thomaslr/plant-esp32/pcb/hole-thru/drc_report.txt

** Drc report for plant-esp32.kicad_pcb **
** Created on 2026-10-13T14:42:54 **
** Report includes: Errors, Warnings **

** Found 0 DRC violations **

** Found 0 unconnected pads **

** Found 0 Footprint errors **

** Ignored checks **
    - Footprint has no courtyard defined
    - Track endpoint not centered on via
    - Tuning profile track geometries
    - Footprint doesn't match symbol's footprint filters
    - Footprint component type doesn't match footprint pads

** End of Report **
