thomaslr/plant-esp32/enclosure/plant_esp32_smd_case_bottom.png

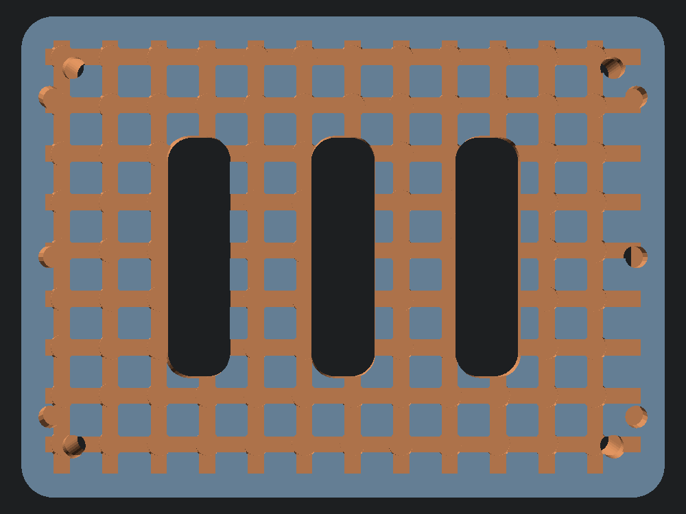
enclosure/plant_esp32_smd_case_bottom.png
