thomaslr/plant-esp32/enclosure/plant_esp32_smd_case_top.png

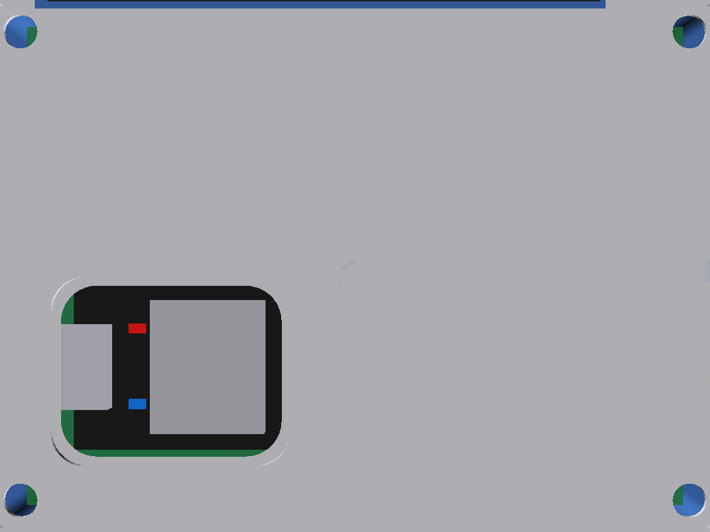
enclosure/plant_esp32_smd_case_top.png
