thomaslr/plant-esp32/enclosure/plant_esp32_smd_open_base_bottom.png

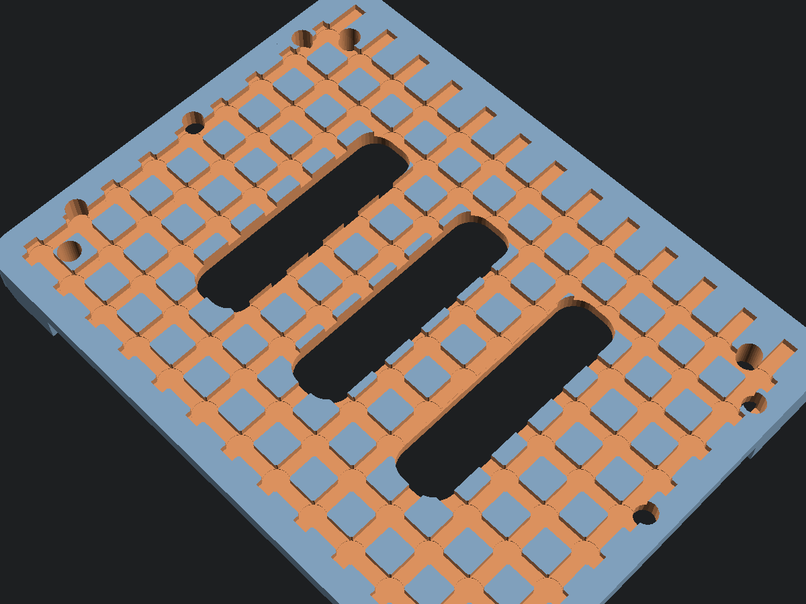
enclosure/plant_esp32_smd_open_base_bottom.png
