thomaslr/plant-esp32/enclosure/plant_esp32_smd_open_base_corner_detail.png

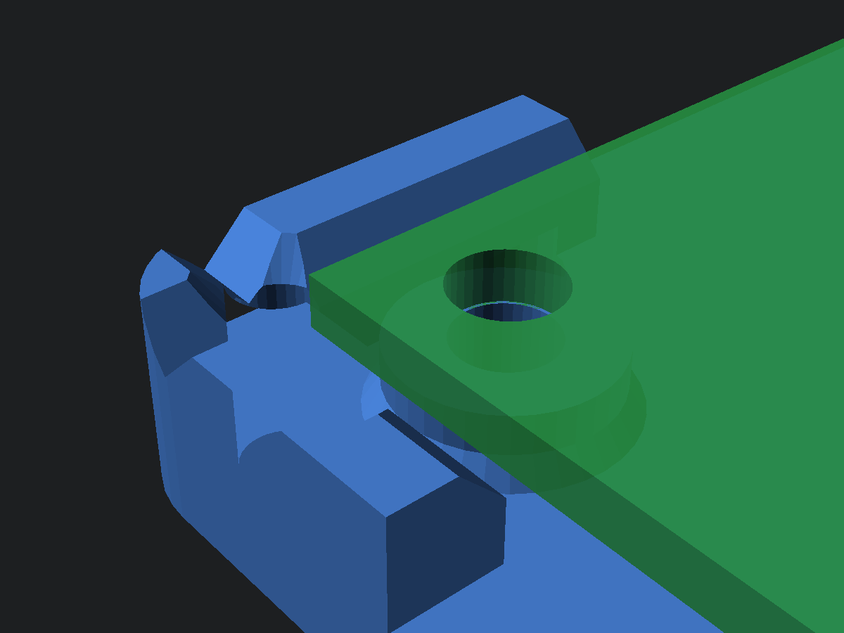
enclosure/plant_esp32_smd_open_base_corner_detail.png
