thomaslr/plant-esp32/pcb/esp32-onboard-smd/plant-esp32-onboard-top.png

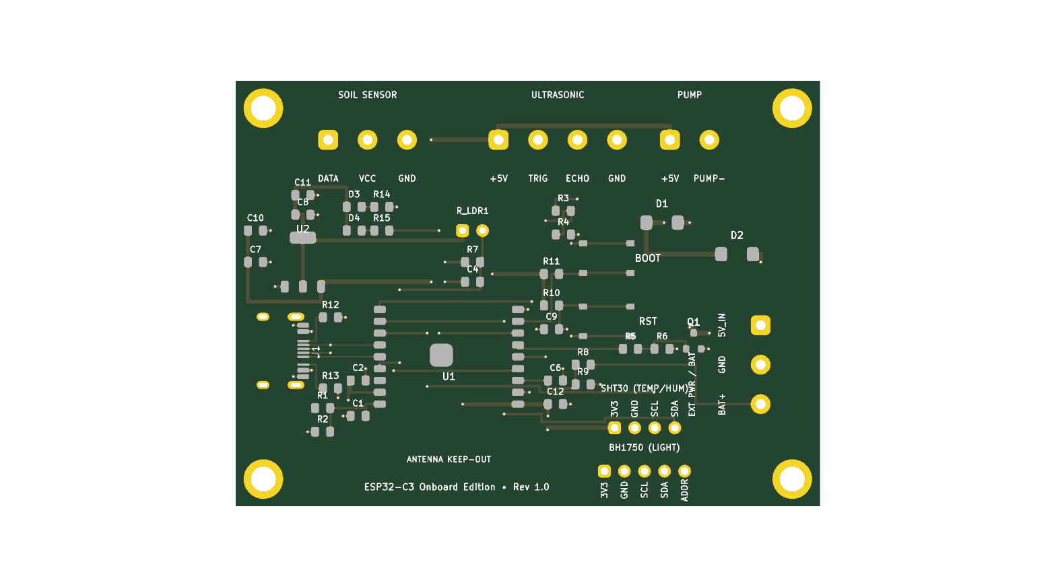
pcb/esp32-onboard-smd/plant-esp32-onboard-top.png
