thomaslr/plant-esp32/pcb/smd/plant-esp32-smd-top.png

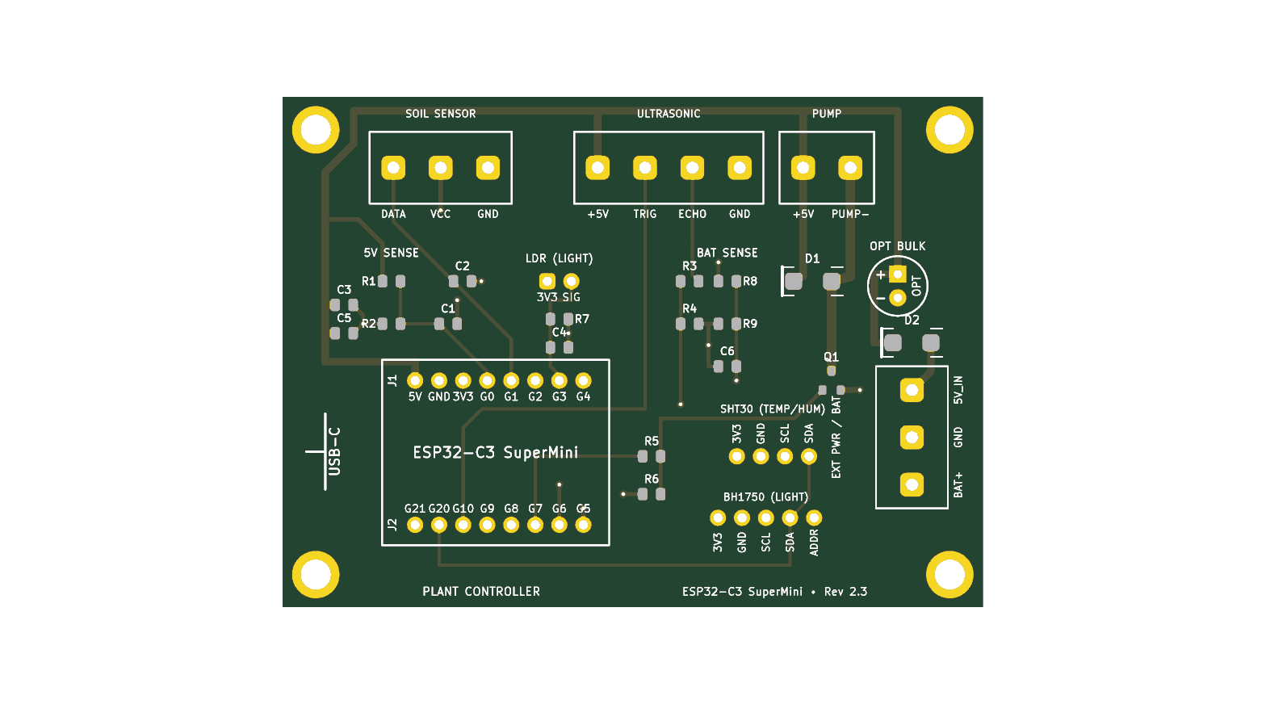
pcb/smd/plant-esp32-smd-top.png
