thomaslr/plant-esp32/pcb/esp32-onboard-smd/plant-esp32-onboard_bom.csv

Comment | Designator | Footprint | LCSC Part #
100k | R1,R2,R8,R9,R6 | 0805 | C149504
100nF | C7,C8,C1,C6,C2,C4 | 0805 | C28233
10k | R11,R10,R7 | 0805 | C17414
10uF | C10,C11 | 0805 | C15850
1k | R14,R15,R3,R5 | 0805 | C17513
1uF | C9 | 0805 | C28323
22uF | C12 | 0805 | C45783
2k | R4 | 0805 | C17604
5.1k | R12,R13 | 0805 | C27834
AMS1117-3.3 | U2 | SOT-223 | C6186
AO3400A | Q1 | SOT-23 | C20917
ESP32-C3-WROOM-02 | U1 | ESP32-C3-WROOM-02 | C2934560
PWR_GREEN | D3 | 0805 | C2297
SS34 | D1,D2 | SMA_DO-214AC | C8678
STAT_BLUE | D4 | 0805 | C2293
TS-1187A | SW1,SW2 | TS-1187A | C318884
TYPE-C-16P | J1 | TYPE-C-16P | C165948
