thomaslr/plant-esp32/enclosure/plant_esp32_smd_open_base.stl

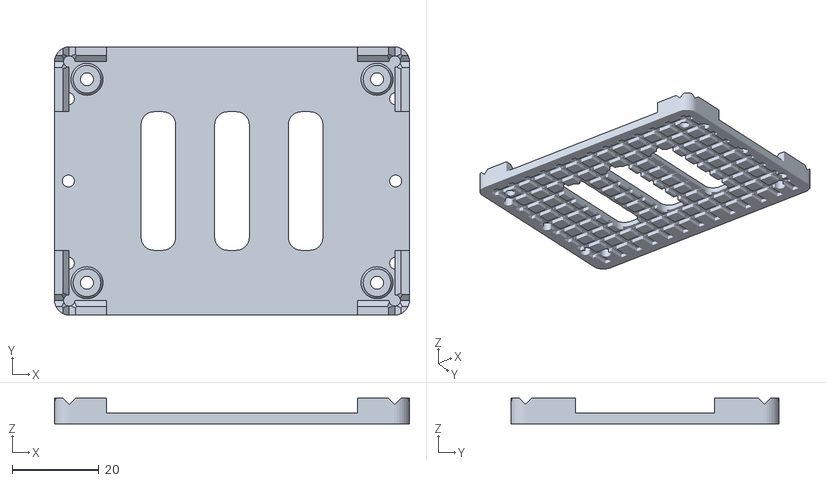
[picture p18: CAD file, 2026-11-05]
enclosure/plant_esp32_smd_open_base.stl
82.0 x 62.0 x 5.90
