thomaslr/plant-esp32/enclosure/plant_esp32_smd_case_base.stl

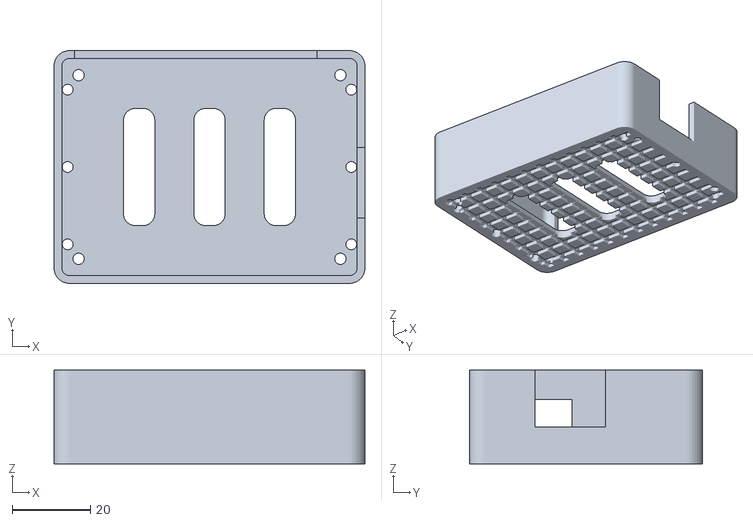
[picture p19: CAD file, 2026-11-05]
enclosure/plant_esp32_smd_case_base.stl
79.6 x 59.6 x 24.0
