thomaslr/plant-esp32/enclosure/plant_esp32_smd_case_lid.stl

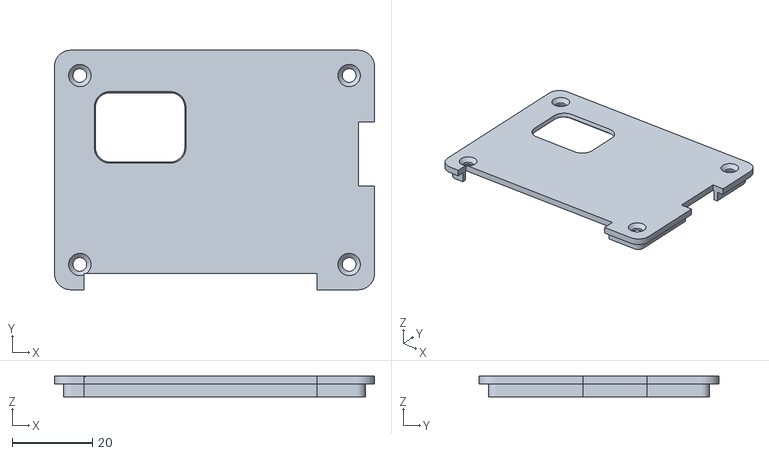
[picture p20: CAD file, 2026-11-05]
enclosure/plant_esp32_smd_case_lid.stl
79.6 x 59.6 x 5.20
