thomaslr/plant-esp32/pcb/smd/plant-esp32-smd.kicad_pcb

## KiCad design pcb/smd/plant-esp32-smd.kicad_pcb (2026-11-06)

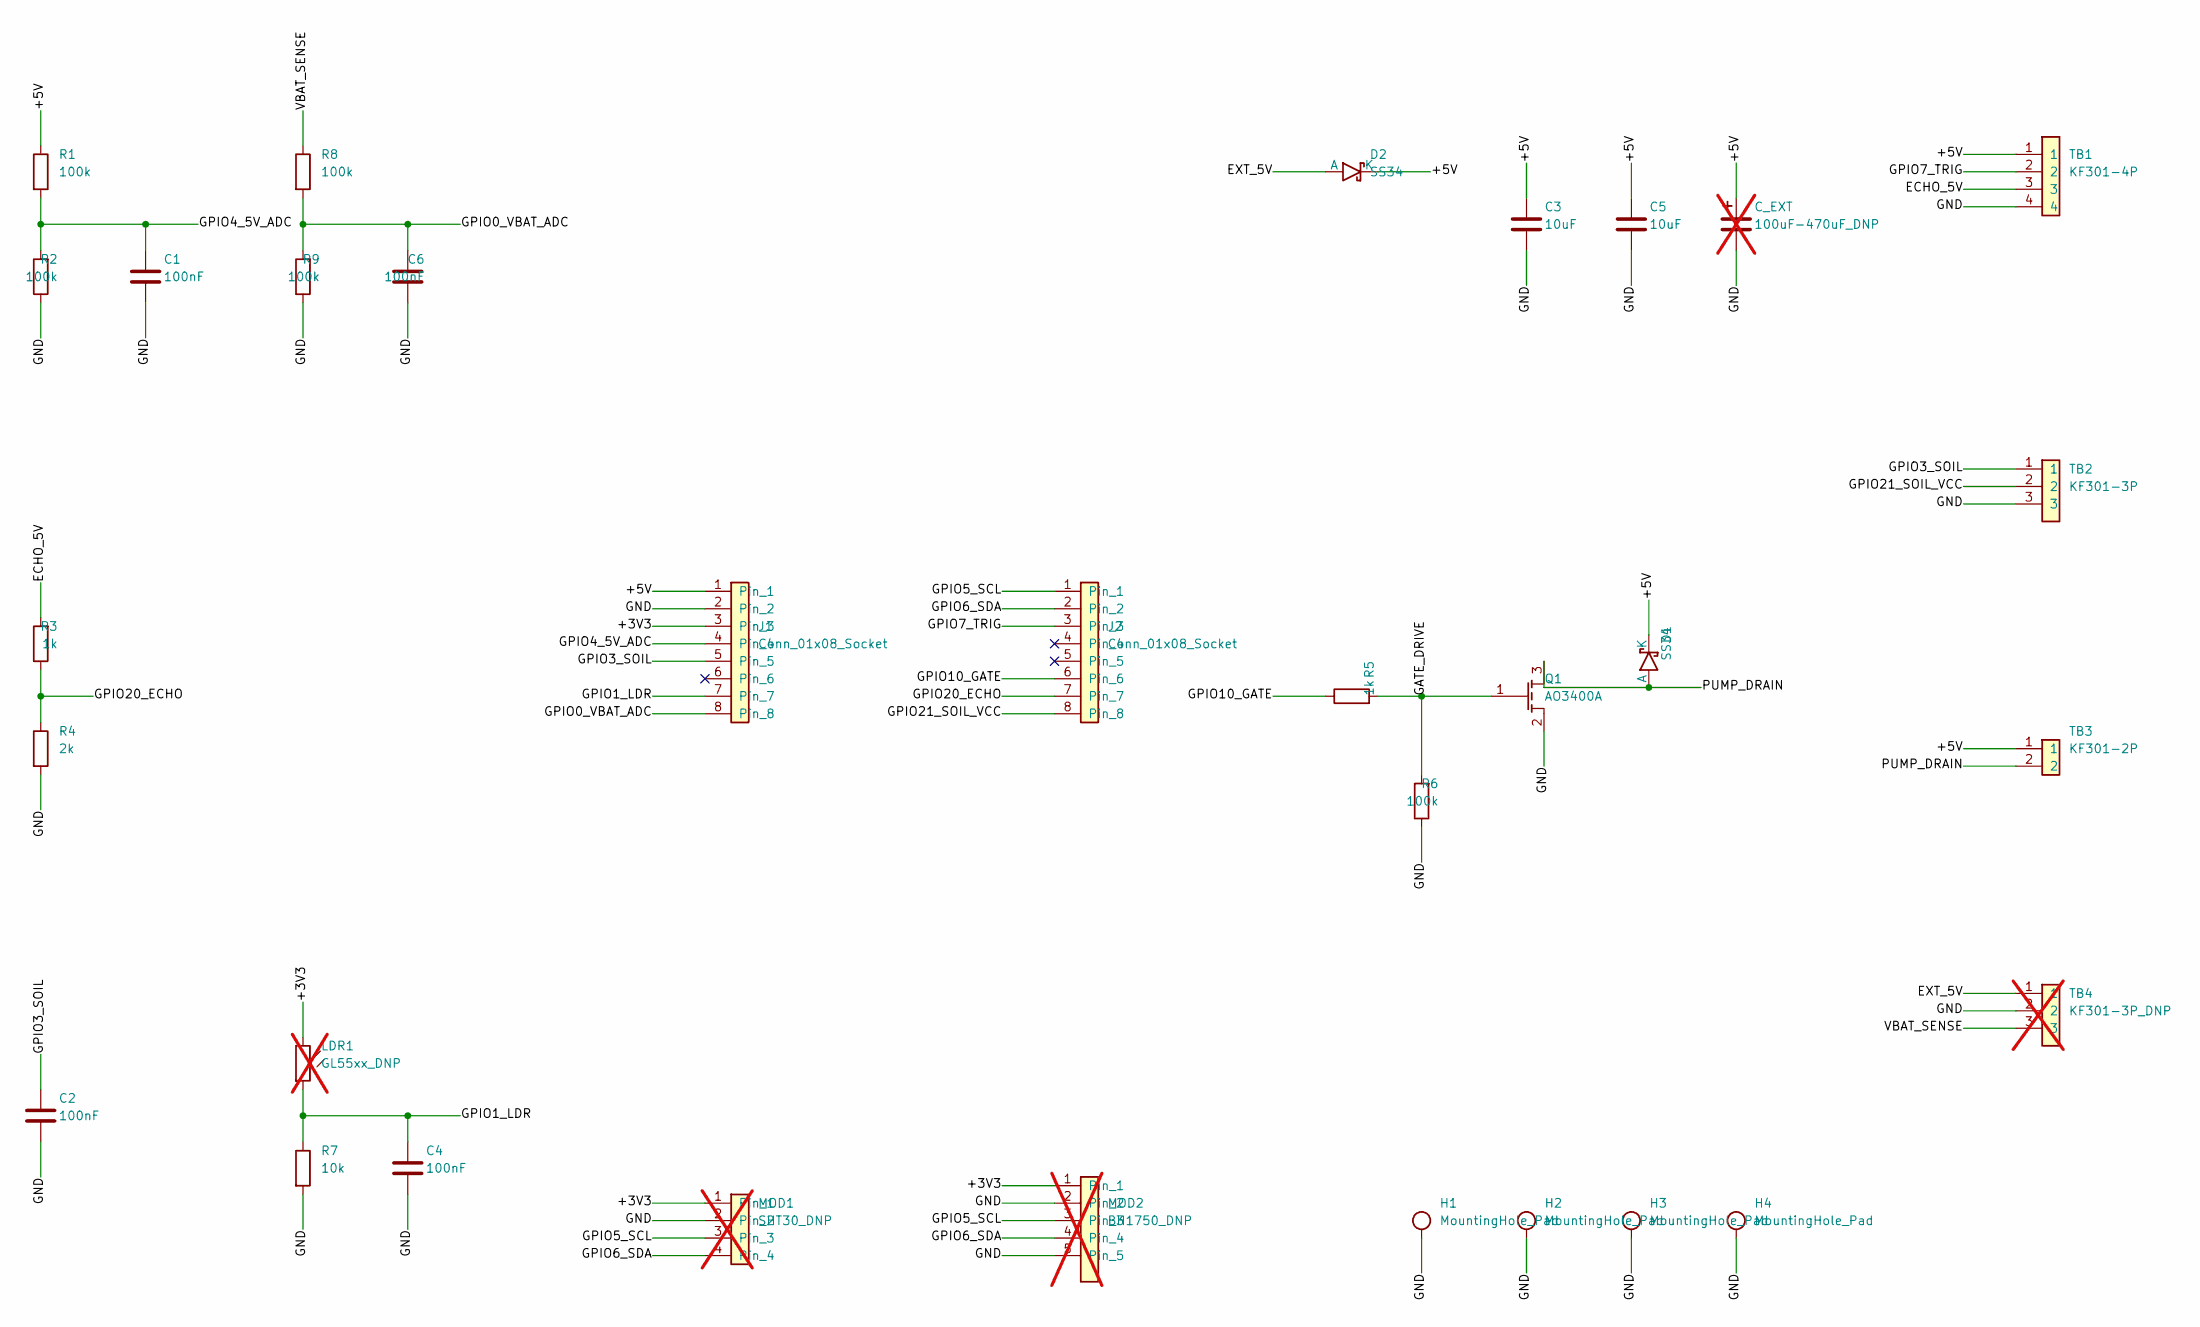
[picture p21: schematic plant-esp32-smd.kicad_sch, Plant Watering & Telemetry Controller (SMD Turnkey Edition …]

Parts:
C1, C2, C4, C6: 100nF; C_0805_2012Metric; LCSC C28233
C3, C5: 10uF; C_0805_2012Metric; LCSC C15850
C_EXT: 100uF-470uF_DNP; CP_Radial_D6.3mm_P2.50mm; not fitted
D1, D2: SS34; D_SMA; LCSC C8678
H1, H2, H3, H4: MountingHole_Pad; MountingHole_3.2mm_M3_Pad
J1, J2: Conn_01x08_Socket; PinSocket_1x08_P2.54mm_Vertical; LCSC C224346
LDR1: GL55xx_DNP; PinHeader_1x02_P2.54mm_Vertical; not fitted
MOD1: SHT30_DNP; PinSocket_1x04_P2.54mm_Vertical; not fitted
MOD2: BH1750_DNP; PinSocket_1x05_P2.54mm_Vertical; not fitted
Q1: AO3400A; SOT-23; LCSC C20917
R1, R2, R6, R8, R9: 100k; R_0805_2012Metric; LCSC C149504
R3, R5: 1k; R_0805_2012Metric; LCSC C17513
R4: 2k; R_0805_2012Metric; LCSC C17604
R7: 10k; R_0805_2012Metric; LCSC C17414
TB1: KF301-4P; TerminalBlock_KF301-4P_P5.00mm; LCSC C8354
TB2: KF301-3P; TerminalBlock_KF301-3P_P5.00mm; LCSC C8353
TB3: KF301-2P; TerminalBlock_KF301-2P_P5.00mm; LCSC C8352
TB4: KF301-3P_DNP; TerminalBlock_KF301-3P_P5.00mm_Vertical; LCSC C8353; not fitted

Connections:
+3V3: J1.3, LDR1.1, MOD1.1, MOD2.1
+5V: C3.1, C5.1, C_EXT.1, D1.1 (K), D2.1 (K), J1.1, R1.1, TB1.1, TB3.1
ECHO_5V: R3.2, TB1.3
EXT_5V: D2.2 (A), TB4.1
GATE_DRIVE: Q1.1 (G), R5.2, R6.2
GND: C1.2, C2.2, C3.2, C4.2, C5.2, C6.1, C_EXT.2, H1.1, H2.1, H3.1, H4.1, J1.2, MOD1.2, MOD2.2, MOD2.5, Q1.2 (S), R2.1, R4.2, R6.1, R7.2, R9.1, TB1.4, TB2.3, TB4.2
GPIO0_VBAT_ADC: C6.2, J1.8, R8.2, R9.2
GPIO1_LDR: C4.1, J1.7, LDR1.2, R7.1
GPIO3_SOIL: C2.1, J1.5, TB2.1
GPIO4_5V_ADC: C1.1, J1.4, R1.2, R2.2
GPIO5_SCL: J2.1, MOD1.3, MOD2.3
GPIO6_SDA: J2.2, MOD1.4, MOD2.4
GPIO7_TRIG: J2.3, TB1.2
GPIO10_GATE: J2.6, R5.1
GPIO20_ECHO: J2.7, R3.1, R4.1
GPIO21_SOIL_VCC: J2.8, TB2.2
PUMP_DRAIN: D1.2 (A), Q1.3 (D), TB3.2
VBAT_SENSE: R8.1, TB4.3

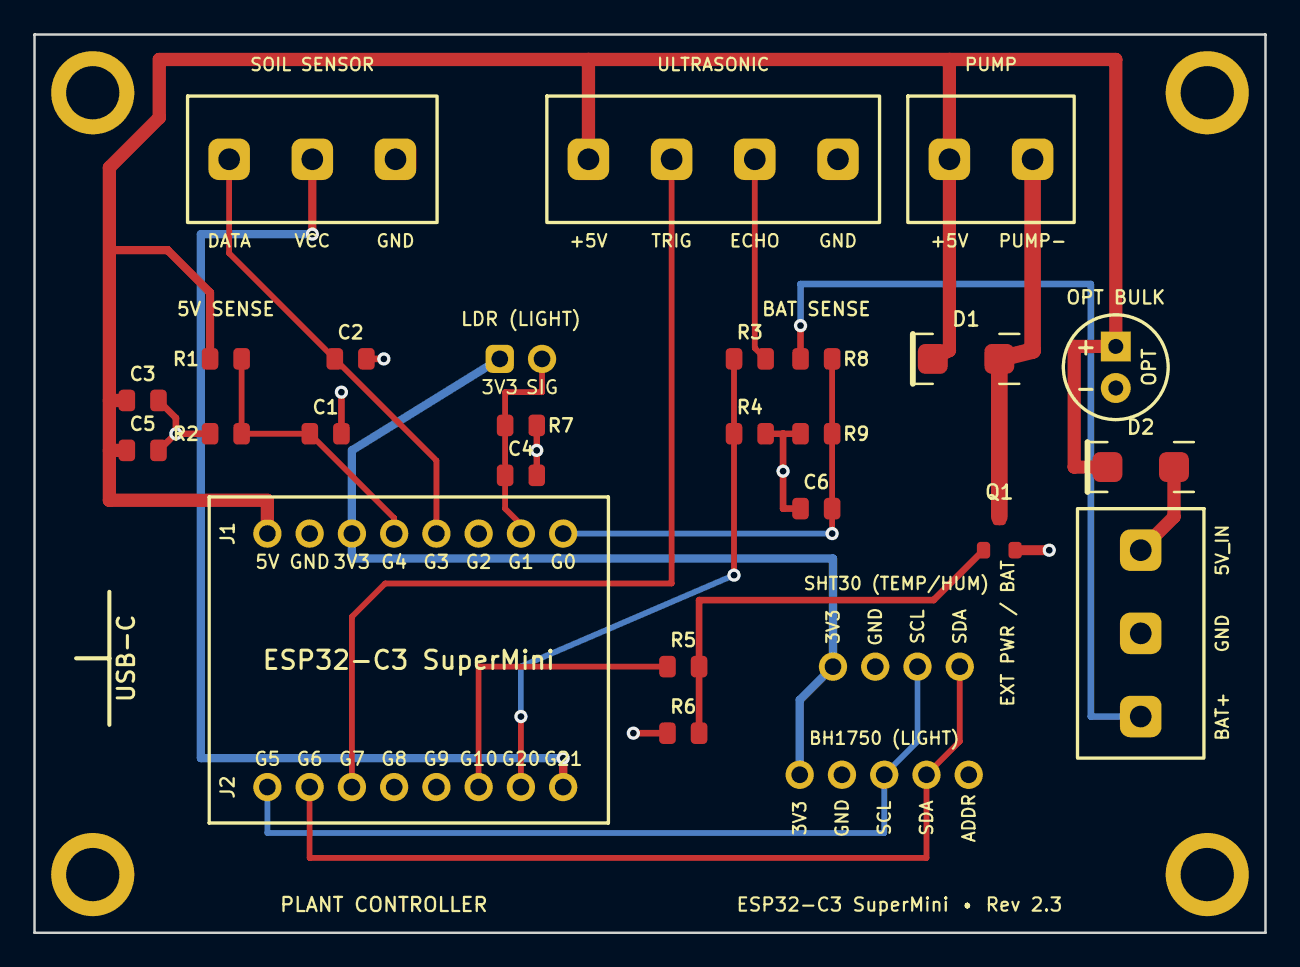
[picture p22: board plant-esp32-smd.kicad_pcb from above]

Board: 2 copper layers, 74.0 x 54.0 mm, 32 parts (0 on the bottom side), 18 nets.
