thomaslr/plant-esp32/pcb/esp32-onboard-smd/plant-esp32-onboard.kicad_pcb

## KiCad design pcb/esp32-onboard-smd/plant-esp32-onboard.kicad_pcb (2026-10-26)

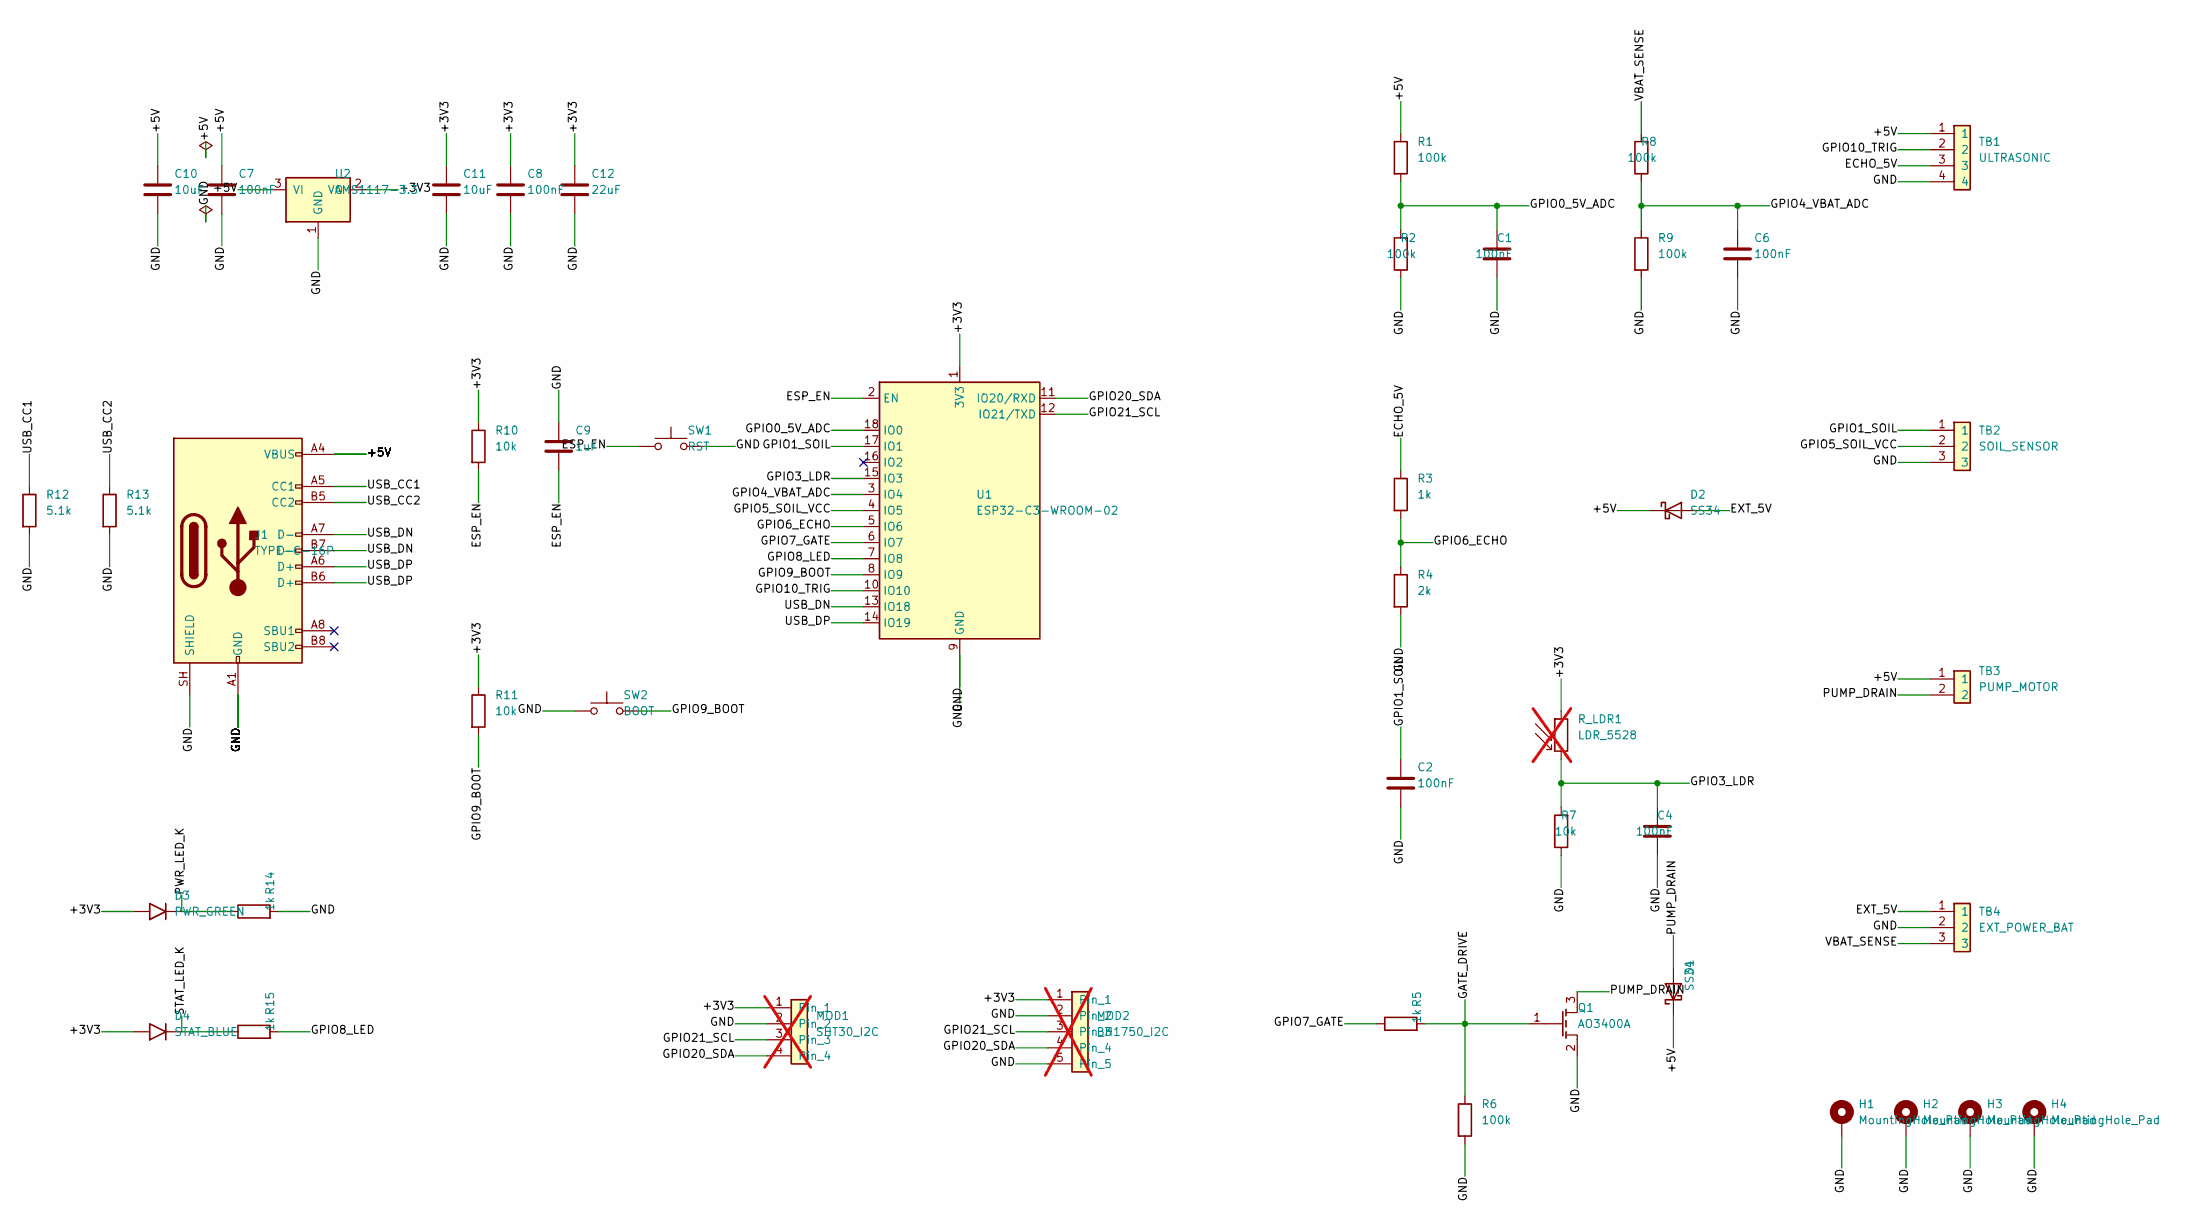
[picture p23: schematic plant-esp32-onboard.kicad_sch, Plant Watering & Telemetry Controller (Onboard ESP32-C3-WRO…]

Parts:
C1, C2, C4, C6, C7, C8: 100nF; C_0805_2012Metric; LCSC C28233
C9: 1uF; C_0805_2012Metric; LCSC C28323
C10, C11: 10uF; C_0805_2012Metric; LCSC C15850
C12: 22uF; C_0805_2012Metric; LCSC C45783
D1, D2: SS34; D_SMA; LCSC C8678
D3: PWR_GREEN; LED_0805_2012Metric; LCSC C2297
D4: STAT_BLUE; LED_0805_2012Metric; LCSC C2293
H1, H2, H3, H4: MountingHole_Pad; MountingHole_3.2mm_M3_Pad
J1: TYPE-C-16P; USB_C_Receptacle_HRO_TYPE-C-31-M-12; LCSC C165948
MOD1: SHT30_I2C; PinSocket_1x04_P2.54mm_Vertical; not fitted
MOD2: BH1750_I2C; PinSocket_1x05_P2.54mm_Vertical; not fitted
Q1: AO3400A; SOT-23; LCSC C20917
R1, R2, R6, R8, R9: 100k; R_0805_2012Metric; LCSC C149504
R3, R5, R14, R15: 1k; R_0805_2012Metric; LCSC C17513
R4: 2k; R_0805_2012Metric; LCSC C17604
R7, R10, R11: 10k; R_0805_2012Metric; LCSC C17414
R12, R13: 5.1k; R_0805_2012Metric; LCSC C27834
R_LDR1: LDR_5528; R_LDR_5.1x4.3mm_P3.4mm_Vertical; not fitted
SW1: RST; SW_Push_1P1T_XKB_TS-1187A; LCSC C318884
SW2: BOOT; SW_Push_1P1T_XKB_TS-1187A; LCSC C318884
TB1: ULTRASONIC; TerminalBlock_KF301-4P_P5.00mm; LCSC C8354
TB2: SOIL_SENSOR; TerminalBlock_KF301-3P_P5.00mm; LCSC C8353
TB3: PUMP_MOTOR; TerminalBlock_KF301-2P_P5.00mm; LCSC C8352
TB4: EXT_POWER_BAT; TerminalBlock_KF301-3P_P5.00mm_Vertical; LCSC C8353
U1: ESP32-C3-WROOM-02; LCSC C2934560
U2: AMS1117-3.3; SOT-223-3_TabPin2; LCSC C6186

Connections:
+3V3: C8.1, C11.1, C12.1, D3.1 (A), D4.1 (A), MOD1.1, MOD2.1, R10.1, R11.1, R_LDR1.1, U1.1 (3V3), U2.2 (VO)
+5V: C7.1, C10.1, D1.1 (K), D2.1 (K), J1.A4 (VBUS), J1.A9 (VBUS), J1.B4 (VBUS), J1.B9 (VBUS), R1.1, TB1.1, TB3.1, U2.3 (VI)
ECHO_5V: R3.1, TB1.3
ESP_EN: C9.2, R10.2, SW1.1, U1.2 (EN)
EXT_5V: D2.2 (A), TB4.1
GATE_DRIVE: Q1.1 (G), R5.2, R6.1
GND: C1.1, C2.2, C4.1, C6.2, C7.2, C8.2, C9.1, C10.2, C11.2, C12.2, H1.1, H2.1, H3.1, H4.1, J1.A1 (GND), J1.A12 (GND), J1.B1 (GND), J1.B12 (GND), J1.SH (SHIELD), MOD1.2, MOD2.2, MOD2.5, Q1.2 (S), R2.1, R4.2, R6.2, R7.1, R9.2, R12.2, R13.2, R14.2, SW1.2, SW2.1, TB1.4, TB2.3, TB4.2, U1.9 (GND), U1.19 (GND), U2.1 (GND)
GPIO0_5V_ADC: C1.2, R1.2, R2.2, U1.18 (IO0)
GPIO1_SOIL: C2.1, TB2.1, U1.17 (IO1)
GPIO3_LDR: C4.2, R7.2, R_LDR1.2, U1.15 (IO3)
GPIO4_VBAT_ADC: C6.1, R8.1, R9.1, U1.3 (IO4)
GPIO5_SOIL_VCC: TB2.2, U1.4 (IO5)
GPIO6_ECHO: R3.2, R4.1, U1.5 (IO6)
GPIO7_GATE: R5.1, U1.6 (IO7)
GPIO8_LED: R15.2, U1.7 (IO8)
GPIO9_BOOT: R11.2, SW2.2, U1.8 (IO9)
GPIO10_TRIG: TB1.2, U1.10 (IO10)
GPIO20_SDA: MOD1.4, MOD2.4, U1.11 (IO20/RXD)
GPIO21_SCL: MOD1.3, MOD2.3, U1.12 (IO21/TXD)
PUMP_DRAIN: D1.2 (A), Q1.3 (D), TB3.2
PWR_LED_K: D3.2 (K), R14.1
STAT_LED_K: D4.2 (K), R15.1
USB_CC1: J1.A5 (CC1), R12.1
USB_CC2: J1.B5 (CC2), R13.1
USB_DN: J1.A7 (D-), J1.B7 (D-), U1.13 (IO18)
USB_DP: J1.A6 (D+), J1.B6 (D+), U1.14 (IO19)
VBAT_SENSE: R8.2, TB4.3

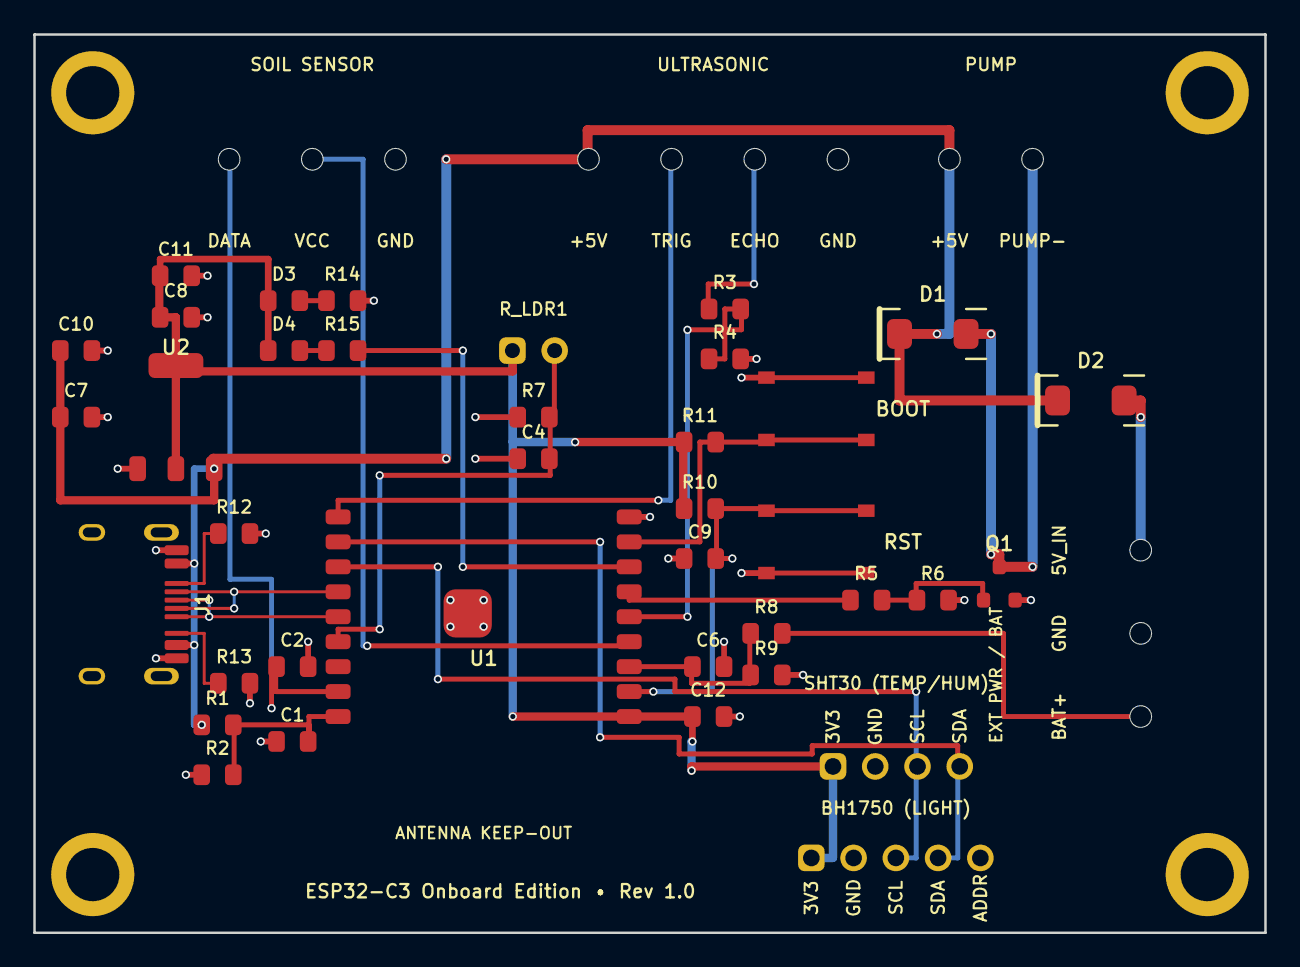
[picture p24: board plant-esp32-onboard.kicad_pcb from above]

Board: 2 copper layers, 74.0 x 54.0 mm, 46 parts (0 on the bottom side), 27 nets.
