thomaslr/plant-esp32/firmware-rust/plant-firmware/src/main.rs

//! Main entry point for the Plant ESP32-C3 Firmware in Rust.
//!
//! Replaces the PlatformIO / Arduino / FreeRTOS C++ firmware.
//! Spawns four concurrent tasks:
//! 1. Safety Supervisor Task (20 Hz / 50ms): Evaluates runtime limits, dry tank cutoffs, and cooldowns.
//! 2. Sensor Acquisition Task: Reads ADC voltages, soil moisture (duty-cycled), and ultrasonic level.
//! 3. Network & Time Supervisor: Maintains Wi-Fi, synchronizes NTP time, and resets daily watering quota at midnight.
//! 4. Visual Status LED Supervisor: Dedicated Round-Robin status signaling on GPIO 8.

mod i2c_bus;
mod led;
mod ota;
mod pins;
mod pump;
mod secrets;
mod sensors;
mod storage;
mod web;
mod wifi;

use std::sync::atomic::AtomicU32;
use std::sync::{Arc, Mutex};
use std::thread;
use std::time::Duration;

use esp_idf_svc::eventloop::EspSystemEventLoop;
use esp_idf_svc::hal::peripherals::Peripherals;
use esp_idf_svc::log::EspLogger;
use esp_idf_svc::mdns::EspMdns;
use esp_idf_svc::nvs::EspDefaultNvsPartition;
use esp_idf_svc::sntp::EspSntp;
use esp_idf_svc::sys::{esp_timer_get_time, link_patches};
use log::{debug, error, info, warn};
use plant_core::safety::SafetyManager;
use plant_core::timeutil::{local_day, local_hour, MidnightTracker};

use crate::led::{init_led_hardware, pulse_setup, run_led_supervisor};
use crate::pump::HardwarePumpGate;
use crate::secrets::{WIFI_PASSWORD, WIFI_SSID};
use crate::sensors::HardwareSensorManager;
use crate::storage::{NvsConfigStorage, WifiCredentials};
use crate::web::{create_provisioning_server, create_web_server, AppState};
use crate::wifi::{start_wifi, WifiState};

fn main() -> anyhow::Result<()> {
    // 1. Link ESP-IDF C patches and initialize logger
    link_patches();
    EspLogger::initialize_default();

    info!("============================================");
    info!("   Plant Monitor & Waterer (Rust Edition)");
    info!("============================================");

    // Boot partition audit: guarantee dual-OTA layout is active
    let ota_status = crate::ota::get_ota_status();
    info!(
        "[BOOT] Running slot: '{}', Standby OTA slot: '{}'",
        ota_status.running_slot, ota_status.next_update_slot
    );
    if ota_status.next_update_slot == "none" || ota_status.running_slot == "factory" {
        log::error!("*******************************************************************************");
        log::error!("⚠️ CRITICAL CONFIGURATION FAULT: FLASH IS NOT PARTITIONED FOR DUAL-OTA!");
        log::error!("   Running on single factory slot without standby partition.");
        log::error!("   Wireless OTA updates WILL FAIL until flashed with plant-firmware/partitions.csv.");
        log::error!("*******************************************************************************");
    }

    // 2. Hardware Peripherals, System Event Loop, and NVS Partition
    let peripherals = Peripherals::take()?;
    let sys_loop = EspSystemEventLoop::take()?;
    let nvs = EspDefaultNvsPartition::take()?;

    // 3. Load persistent configuration from NVS flash
    let storage = NvsConfigStorage::new(nvs.clone())?;
    let mut config = storage.load();
    if !config.wifi.radio_profile_v3 {
        info!("[CONFIG] Upgrading legacy Wi-Fi radio profile to v3 defaults (TX=78, HT20, Modem Sleep=true)");
        config.wifi = plant_core::config::WifiConfig::default();
        let _ = storage.save(&config);
    }

    // 4. Resolve saved Wi-Fi credentials (NVS first, secrets.rs developer fallback second)
    let saved_wifi = storage.load_wifi().or_else(|| {
        if !WIFI_SSID.is_empty() && WIFI_SSID != "YOUR_WIFI_SSID" {
            info!("[WIFI] Using developer credentials from secrets.rs and saving to NVS");
            let _ = storage.save_wifi(WIFI_SSID, WIFI_PASSWORD);
            Some(WifiCredentials {
                ssid: WIFI_SSID.to_string(),
                password: WIFI_PASSWORD.to_string(),
            })
        } else {
            None
        }
    });

    // Remember whether we have credentials worth retrying if the router was unreachable at boot.
    let had_saved_wifi = saved_wifi.is_some();

    // 5. Connect to Wi-Fi (Station Mode) or launch Captive Portal (Provisioning SoftAP)
    let wifi_state = start_wifi(
        peripherals.modem,
        sys_loop,
        Some(nvs),
        saved_wifi,
        &config.system.hostname,
        &config.wifi,
    )?;

    match wifi_state {
        WifiState::ProvisioningMode {
            ap_ssid,
            scanned_ssids,
            wifi_handle,
        } => {
            info!("============================================");
            info!("   PROVISIONING SOFTAP ACTIVE");
            info!("   1. Connect your phone to: '{}'", ap_ssid);
            info!("   2. Open browser to: http://192.168.4.1");
            info!("============================================");

            let s_storage = Arc::new(Mutex::new(storage));
            let s_ssids = Arc::new(Mutex::new(scanned_ssids));
            let srv = create_provisioning_server(s_storage, s_ssids)?;
            core::mem::forget(srv);
            core::mem::forget(wifi_handle);

            // Fast LED blink (100ms ON / 100ms OFF) to indicate setup mode.
            // If we have saved credentials (router was just temporarily unreachable),
            // self-heal by rebooting after 5 minutes to retry them instead of staying
            // stuck in the setup hotspot forever.
            init_led_hardware();
            let provisioning_started = std::time::Instant::now();
            loop {
                pulse_setup();
                if had_saved_wifi && provisioning_started.elapsed() > Duration::from_secs(300) {
                    warn!("[WIFI] Still offline with saved credentials. Rebooting to retry...");
                    unsafe {
                        esp_idf_svc::sys::esp_restart();
                    }
                }
            }
        }
        WifiState::StationConnected {
            ip_address,
            wifi_handle,
        } => {
            // 6. Initialize Hardware Pump Gate (5 kHz LEDC PWM) and Safety Supervisor
            let pump_speed = Arc::new(AtomicU32::new(config.timing.pump_speed_pct));
            let pump_gate = HardwarePumpGate::new(Arc::clone(&pump_speed));
            let safety = SafetyManager::new(&config, pump_gate);

            // 7. Initialize Sensor Manager & 150-sample Persistent Flash Ring Buffer
            let sensors = Arc::new(HardwareSensorManager::new());
            let history = storage.load_history(plant_core::reading::MAX_HISTORY_CAPACITY);

            // 8. Start SNTP Time Synchronization
            let primary_ntp = config
                .system
                .ntp_servers
                .first()
                .map(|s| s.as_str())
                .unwrap_or("pool.ntp.org");
            let sntp_conf = esp_idf_svc::sntp::SntpConf {
                servers: [primary_ntp],
                operating_mode: esp_idf_svc::sntp::OperatingMode::Poll,
                sync_mode: esp_idf_svc::sntp::SyncMode::Immediate,
            };
            let _sntp = match EspSntp::new(&sntp_conf) {
                Ok(sntp) => {
                    info!("[NTP] SNTP client initialized with server: {}", primary_ntp);
                    unsafe {
                        // Resync hourly (3,600,000 ms = 24 times per day)
                        esp_idf_svc::sys::sntp_set_sync_interval(3600 * 1000);
                    }
                    core::mem::forget(sntp);
                    true
                }
                Err(e) => {
                    warn!("[NTP] Failed to initialize SNTP: {:?}", e);
                    false
                }
            };

            // 9. Initialize mDNS Responder (e.g. plants.local or plants1.local)
            let _mdns = match EspMdns::take() {
                Ok(mut mdns) => {
                    let host = &config.system.hostname;
                    if let Err(e) = mdns.set_hostname(host) {
                        warn!("[mDNS] Failed to set hostname '{}': {:?}", host, e);
                    } else {
                        info!("[mDNS] Responder active at http://{}.local", host);
                    }
                    let _ = mdns.set_instance_name(&format!("Plant Monitor ({})", host));
                    let _ = mdns.add_service(None, "_http", "_tcp", 80, &[("board", "esp32c3")]);
                    Some(mdns)
                }
                Err(e) => {
                    warn!("[mDNS] Failed to initialize mDNS: {:?}", e);
                    None
                }
            };

            // 10. Construct shared application state
            let state = Arc::new(Mutex::new(AppState {
                config: config.clone(),
                safety,
                sensors,
                history,
                storage,
                ip_address,
                wifi_rssi: -60,
                pump_speed,
            }));

            // 11. Start Embedded HTTP Web Server
            let _server = match create_web_server(Arc::clone(&state)) {
                Ok(srv) => {
                    info!("[SYS] HTTP server and REST endpoints listening on port 80");
                    Some(srv)
                }
                Err(e) => {
                    warn!("[SYS] Failed to bind HTTP server: {:?}", e);
                    None
                }
            };

            // Prevent server, mdns and wifi from being dropped
            if let Some(srv) = _server {
                core::mem::forget(srv);
            }
            if let Some(mdns) = _mdns {
                core::mem::forget(mdns);
            }
            core::mem::forget(wifi_handle);

    // 10. Task 1: Safety & Pump Supervisor (Priority: HIGH, 20 Hz / 50ms)
    let s_safety = Arc::clone(&state);
    thread::Builder::new()
        .name("SafetySupervisor".to_string())
        .stack_size(4096)
        .spawn(move || loop {
            {
                let mut app = s_safety.lock().unwrap();
                let now_ms = unsafe { (esp_timer_get_time() / 1000) as u32 };
                app.safety.tick(now_ms);
            }
            thread::sleep(Duration::from_millis(50));
        })?;

    // 11. Task 2: Sensor Acquisition & Auto-Watering (Priority: NORMAL)
    let s_sensors = Arc::clone(&state);
    let startup_delay_sec = config.timing.startup_delay_sec;
    thread::Builder::new()
        .name("SensorAcquisition".to_string())
        .stack_size(8192)
        .spawn(move || {
            // Initial startup delay to let power supplies and sensors stabilize
            info!(
                "[SENSOR] Startup settle delay: {} seconds",
                startup_delay_sec
            );
            thread::sleep(Duration::from_secs(startup_delay_sec as u64));

            loop {
                let (pump_active, config, interval_sec, sensors) = {
                    let app = s_sensors.lock().unwrap();
                    (
                        app.safety.is_pump_active(),
                        app.config.clone(),
                        app.config.timing.sensor_read_interval_sec,
                        Arc::clone(&app.sensors),
                    )
                };

                // Read all hardware sensors outside the AppState mutex so web requests
                // and the 20 Hz SafetySupervisor are never stalled during probe settling
                let reading = sensors.read_all_sensors(pump_active, &config);

                // Push reading into circular RAM ring buffer and commit to flash
                {
                    let mut app = s_sensors.lock().unwrap();
                    app.history.push(reading.clone());
                    if let Err(e) = app.storage.save_history(&app.history) {
                        warn!("[SENSOR] Failed to persist history to flash: {}", e);
                    }
                }

                info!(
                    "[SENSOR] Soil: {:.1}% | Water: {:.1}cm | 5V Rail: {:.2}V | Bat: {:.2}V | Chip: {:.1}°C",
                    reading.soil_percent,
                    reading.water_level_cm,
                    reading.supply_voltage,
                    reading.battery_voltage,
                    reading.chip_temp
                );

                // Automated Watering Logic
                if !pump_active {
                    let soil = reading.soil_percent;
                    let threshold = config.gauges.soil_moisture.trigger_threshold as f32;
                    let min_water = config.gauges.water_level.min_safe_level_cm;

                    if soil < threshold && reading.water_level_cm >= min_water {
                        let duration = config.timing.automated_water_duration_sec;
                        let now_unix = std::time::SystemTime::now()
                            .duration_since(std::time::UNIX_EPOCH)
                            .map(|d| d.as_secs() as i64)
                            .unwrap_or(0);
                        let hour = local_hour(now_unix, config.system.gmt_offset);

                        let mut app = s_sensors.lock().unwrap();
                        let now_ms = unsafe { (esp_timer_get_time() / 1000) as u32 };
                        let result = app.safety.request_watering(
                            now_ms,
                            duration,
                            "Soil dry trigger",
                            reading.water_level_cm,
                            hour,
                        );

                        if let Ok(actual_duration) = result {
                            info!(
                                "[AUTO] Low soil moisture ({:.1}% < {:.0}%). Started watering for {}s",
                                soil, threshold, actual_duration
                            );
                        }
                    }
                }

                let safe_interval = if interval_sec < 5 { 5 } else { interval_sec };
                thread::sleep(Duration::from_secs(safe_interval as u64));
            }
        })?;

    // 12. Task 3: Midnight Daily Quota Reset & System Monitor (Priority: LOW)
    let s_monitor = Arc::clone(&state);
    thread::Builder::new()
        .name("MidnightTracker".to_string())
        .stack_size(4096)
        .spawn(move || {
            let mut tracker = MidnightTracker::new();
            let mut ntp_synced_logged = false;
            let mut unsynced_ticks = 0u32;
            loop {
                thread::sleep(Duration::from_secs(60));

                let gmt_offset = {
                    let app = s_monitor.lock().unwrap();
                    app.config.system.gmt_offset
                };

                let now_unix = std::time::SystemTime::now()
                    .duration_since(std::time::UNIX_EPOCH)
                    .map(|d| d.as_secs() as i64)
                    .unwrap_or(0);

                if now_unix > 1_600_000_000 {
                    if !ntp_synced_logged {
                        info!("[NTP] Clock synchronized successfully with NTP (Unix: {})", now_unix);
                        ntp_synced_logged = true;
                    }
                    unsynced_ticks = 0;
                } else {
                    unsynced_ticks += 1;
                    if unsynced_ticks % 5 == 0 {
                        warn!(
                            "[NTP] Awaiting NTP time sync (minute {})... restarting SNTP probe",
                            unsynced_ticks
                        );
                        unsafe {
                            esp_idf_svc::sys::sntp_restart();
                        }
                    }
                }

                let day = local_day(now_unix, gmt_offset);
                if tracker.update(day) {
                    info!("[NTP] Midnight reached: resetting daily watering quota");
                    let mut app = s_monitor.lock().unwrap();
                    app.safety.reset_daily_quota();
                }
            }
        })?;

    // 13. Task 4: Visual Status LED Supervisor (Priority: NORMAL, Round-Robin Faults)
    let s_led = Arc::clone(&state);
    thread::Builder::new()
        .name("LedSupervisor".to_string())
        .stack_size(4096)
        .spawn(move || {
            run_led_supervisor(s_led);
        })?;

    // 14. Task 5: Network Heartbeat, Live RSSI & Watchdog (Priority: LOW, every 30s)
    // - Broadcasts periodic UDP keep-alive / Gratuitous ARP to prevent mesh routers
    //   (e.g. TP-Link Deco) from dropping the station from bridge and ARP tables.
    // - Queries driver directly for real-time Wi-Fi signal strength (RSSI in dBm).
    // - Automatically self-heals via reboot if connection is lost continuously for >4 minutes.
    let s_net = Arc::clone(&state);
    thread::Builder::new()
        .name("NetworkWatchdog".to_string())
        .stack_size(4096)
        .spawn(move || {
            let mut failed_checks = 0u32;
            let socket = std::net::UdpSocket::bind("0.0.0.0:0").ok();
            if let Some(ref s) = socket {
                let _ = s.set_broadcast(true);
                let _ = s.set_write_timeout(Some(Duration::from_millis(500)));
            }

            loop {
                thread::sleep(Duration::from_secs(30));

                let mut ap_info = std::mem::MaybeUninit::<esp_idf_svc::sys::wifi_ap_record_t>::uninit();
                let is_connected = unsafe {
                    esp_idf_svc::sys::esp_wifi_sta_get_ap_info(ap_info.as_mut_ptr()) == 0
                };

                if is_connected {
                    let ap_record = unsafe { ap_info.assume_init() };
                    let rssi = ap_record.rssi as i32;
                    failed_checks = 0;

                    // Update live signal strength in shared state
                    {
                        let mut app = s_net.lock().unwrap();
                        app.wifi_rssi = rssi;
                    }

                    // Transmit periodic heartbeat frame to refresh router ARP/bridge tables
                    if let Some(ref s) = socket {
                        let _ = s.send_to(b"PLANT_HEARTBEAT", "255.255.255.255:3826");
                    }
                } else {
                    failed_checks += 1;
                    warn!(
                        "[NET] Wi-Fi link inactive or disconnected (consecutive check: {})",
                        failed_checks
                    );
                    if failed_checks >= 8 {
                        error!("[NET] Connection lost for >4 minutes. Triggering self-recovery reboot...");
                        unsafe {
                            esp_idf_svc::sys::esp_restart();
                        }
                    }
                }
            }
        })?;

    // 15. Task 6: Autonomous OTA Version Checker (Priority: LOW)
    // - Checks shortly after boot (~60s after startup once Wi-Fi & NTP stabilize)
    // - Checks once per day after midnight (~02:00 AM local time)
    let s_ota_cfg = Arc::clone(&state);
    if let Err(e) = crate::ota::start_periodic_ota_check(move || {
        s_ota_cfg.lock().unwrap().config.system.gmt_offset
    }) {
        warn!("[SYS] Failed to launch autonomous OTA checker: {:?}", e);
    }

    // 16. Task 7: Hardware BOOT Button Monitor (Priority: LOW, 10 Hz)
    // - Holding the onboard BOOT button (GPIO 9) for 5 seconds clears Wi-Fi credentials
    //   from NVS and reboots into SoftAP Provisioning mode.
    // - Option 1 Telemetry: Solid ON while held, followed by 5 rapid confirmation blips upon 5s reset.
    let s_btn = Arc::clone(&state);
    thread::Builder::new()
        .name("ButtonMonitor".to_string())
        .stack_size(3072)
        .spawn(move || {
            use esp_idf_svc::sys::{
                gpio_get_level, gpio_mode_t_GPIO_MODE_INPUT,
                gpio_pull_mode_t_GPIO_PULLUP_ONLY, gpio_reset_pin, gpio_set_direction,
                gpio_set_pull_mode,
            };
            use crate::pins::PIN_BOOT_BUTTON;
            use crate::led::{
                is_boot_button_held, led_off, play_factory_reset_confirmed,
                set_boot_button_held, set_factory_reset_in_progress,
            };

            unsafe {
                gpio_reset_pin(PIN_BOOT_BUTTON);
                gpio_set_direction(PIN_BOOT_BUTTON, gpio_mode_t_GPIO_MODE_INPUT);
                gpio_set_pull_mode(PIN_BOOT_BUTTON, gpio_pull_mode_t_GPIO_PULLUP_ONLY);
            }

            let mut hold_ticks = 0u32;
            loop {
                thread::sleep(Duration::from_millis(100));
                let is_pressed = unsafe { gpio_get_level(PIN_BOOT_BUTTON) == 0 };
                if is_pressed {
                    // Suppress factory reset during active OTA firmware flash writing
                    if crate::ota::is_ota_in_progress() {
                        continue;
                    }

                    hold_ticks += 1;
                    if !is_boot_button_held() {
                        set_boot_button_held(true);
                    }

                    if hold_ticks == 20 {
                        info!("[BUTTON] BOOT button held for 2s... continue holding to factory reset");
                    } else if hold_ticks >= 50 {
                        log::error!("****************************************************************");
                        log::error!("🔘 [BUTTON] HARDWARE FACTORY RESET TRIGGERED! (5s hold on BOOT)");
                        log::error!("   Erasing Wi-Fi credentials and rebooting into setup portal...");
                        log::error!("****************************************************************");

                        // 1. Take exclusive LED ownership and play 5 rapid confirmation blips
                        set_factory_reset_in_progress(true);
                        set_boot_button_held(false);
                        play_factory_reset_confirmed();

                        // 2. Erase Wi-Fi credentials from NVS flash
                        {
                            let app = s_btn.lock().unwrap();
                            let _ = app.storage.clear_wifi();
                        }
                        thread::sleep(Duration::from_millis(200));

                        // 3. Reboot into SoftAP Provisioning mode
                        unsafe {
                            esp_idf_svc::sys::esp_restart();
                        }
                    }
                } else {
                    if hold_ticks > 0 && hold_ticks < 50 {
                        debug!("[BUTTON] BOOT button released after {}ms (reset aborted)", hold_ticks * 100);
                        set_boot_button_held(false);
                        led_off();
                    }
                    hold_ticks = 0;
                }
            }
        })?;

    info!("[SYS] All background tasks successfully spawned. System running.");

    // 14. Confirm successful boot to bootloader to permanently cancel OTA rollback
    crate::ota::mark_running_app_valid();

    // Keep main thread alive
            loop {
                thread::sleep(Duration::from_secs(3600));
            }
        }
    }
}
