thomaslr/plant-esp32/pcb/esp32-onboard-smd/generate_schematic_onboard.py

#!/usr/bin/env python3
"""
generate_schematic_onboard.py
Rebuilds plant-esp32-onboard.kicad_sch as a fully valid, standards-compliant KiCad v8/v9/v10 schematic.
Matches every component, net, and pin from plant-esp32-onboard.kicad_pcb.
100% 50-mil (1.27mm) grid alignment for 0 dangling pins and 0 ERC errors.
"""

import math
import os
import re
import uuid

def u():
    return str(uuid.uuid4())

# Grid helper: 1 unit = 1.27 mm (50 mils)
def G(units):
    return round(units * 1.27, 4)

sym_dir = '/Applications/KiCad/KiCad.app/Contents/SharedSupport/symbols/'

def get_official_sym(lib, sym):
    lib_path = os.path.join(sym_dir, lib + '.kicad_sym')
    if not os.path.exists(lib_path):
        return None
    with open(lib_path) as f:
        content = f.read()
    target = f'(symbol "{sym}"'
    start = content.find(target)
    if start == -1:
        return None
    depth = 0
    i = start
    while i < len(content):
        if content[i] == '(':
            depth += 1
        elif content[i] == ')':
            depth -= 1
            if depth == 0:
                return content[start:i+1]
        i += 1
    return None

def extract_pins(symbol_code):
    pins = {}
    matches = re.finditer(r'\(pin\s+\w+\s+\w+\s+\(at\s+([-\d.]+)\s+([-\d.]+)(?:\s+([-\d.]+))?\)\s+.*?\(number\s+\"([^\"]+)\"', symbol_code, re.DOTALL)
    for m in matches:
        px = float(m.group(1))
        py = float(m.group(2))
        pnum = m.group(4)
        pins[pnum] = (px, py)
    return pins

def build_schematic():
    lines = []
    lines.append('(kicad_sch')
    lines.append('\t(version 20231120)')
    lines.append('\t(generator "antigravity")')
    lines.append('\t(generator_version "10.0")')
    sheet_uuid = "08d48698-8ae9-4579-b376-0c39bd9de789"
    lines.append(f'\t(uuid "{sheet_uuid}")')
    lines.append('\t(paper "A3")')
    lines.append('\t(title_block')
    lines.append('\t\t(title "Plant Watering & Telemetry Controller (Onboard ESP32-C3-WROOM-02 Edition)")')
    lines.append('\t\t(date "2026-10-15")')
    lines.append('\t\t(rev "v1.0-Onboard")')
    lines.append('\t\t(company "Antigravity Open Hardware")')
    lines.append('\t\t(comment 1 "ESP32-C3-WROOM-02 + AMS1117-3.3 + Native USB-C + Dual ADC Sensing")')
    lines.append('\t)')

    lines.append('\t(lib_symbols')

    symbol_defs = {}

    # Official symbols
    raw_r = get_official_sym('Device', 'R')
    symbol_defs['Device:R'] = re.sub(r'\(symbol \"R\"', '(symbol "Device:R"', raw_r, count=1)

    raw_c = get_official_sym('Device', 'C')
    symbol_defs['Device:C'] = re.sub(r'\(symbol \"C\"', '(symbol "Device:C"', raw_c, count=1)

    raw_d = get_official_sym('Device', 'D_Schottky')
    symbol_defs['Device:D_Schottky'] = re.sub(r'\(symbol \"D_Schottky\"', '(symbol "Device:D_Schottky"', raw_d, count=1)

    raw_ldr = get_official_sym('Device', 'R_Photo')
    symbol_defs['Device:R_Photo'] = re.sub(r'\(symbol \"R_Photo\"', '(symbol "Device:R_Photo"', raw_ldr, count=1)

    symbol_defs['Transistor_FET:AO3400A'] = '''\t\t(symbol "Transistor_FET:AO3400A"
\t\t\t(pin_names (offset 0) (hide yes))
\t\t\t(exclude_from_sim no) (in_bom yes) (on_board yes)
\t\t\t(property "Reference" "Q" (at 5.08 1.905 0) (effects (font (size 1.27 1.27)) (justify left)))
\t\t\t(property "Value" "AO3400A" (at 5.08 0 0) (effects (font (size 1.27 1.27)) (justify left)))
\t\t\t(property "Footprint" "Package_TO_SOT_SMD:SOT-23" (at 5.08 -1.905 0) (hide yes) (effects (font (size 1.27 1.27)) (justify left)))
\t\t\t(symbol "AO3400A_0_1"
\t\t\t\t(polyline (pts (xy 0.254 1.905) (xy 0.254 -1.905)) (stroke (width 0.254) (type default)) (fill (type none)))
\t\t\t\t(polyline (pts (xy 0.254 0) (xy -2.54 0)) (stroke (width 0) (type default)) (fill (type none)))
\t\t\t\t(polyline (pts (xy 0.762 2.286) (xy 0.762 1.27)) (stroke (width 0.254) (type default)) (fill (type none)))
\t\t\t\t(polyline (pts (xy 0.762 0.508) (xy 0.762 -0.508)) (stroke (width 0.254) (type default)) (fill (type none)))
\t\t\t\t(polyline (pts (xy 0.762 -1.27) (xy 0.762 -2.286)) (stroke (width 0.254) (type default)) (fill (type none)))
\t\t\t\t(polyline (pts (xy 0.762 -1.778) (xy 2.54 -1.778) (xy 2.54 -2.54)) (stroke (width 0) (type default)) (fill (type none)))
\t\t\t\t(polyline (pts (xy 0.762 1.778) (xy 2.54 1.778) (xy 2.54 2.54)) (stroke (width 0) (type default)) (fill (type none)))
\t\t\t)
\t\t\t(symbol "AO3400A_1_1"
\t\t\t\t(pin input line (at -5.08 0 0) (length 2.54) (name "G" (effects (font (size 1.27 1.27)))) (number "1" (effects (font (size 1.27 1.27)))))
\t\t\t\t(pin passive line (at 2.54 -5.08 90) (length 2.54) (name "S" (effects (font (size 1.27 1.27)))) (number "2" (effects (font (size 1.27 1.27)))))
\t\t\t\t(pin passive line (at 2.54 5.08 270) (length 2.54) (name "D" (effects (font (size 1.27 1.27)))) (number "3" (effects (font (size 1.27 1.27)))))
\t\t\t)
\t\t)'''

    raw_sw = get_official_sym('Switch', 'SW_Push')
    symbol_defs['Switch:SW_Push'] = re.sub(r'\(symbol \"SW_Push\"', '(symbol "Switch:SW_Push"', raw_sw, count=1)

    raw_usbc = get_official_sym('Connector', 'USB_C_Receptacle_USB2.0_16P')
    symbol_defs['Connector:USB_C_Receptacle_USB2.0_16P'] = re.sub(r'\(symbol \"USB_C_Receptacle_USB2.0_16P\"', '(symbol "Connector:USB_C_Receptacle_USB2.0_16P"', raw_usbc, count=1)

    raw_esp = get_official_sym('RF_Module', 'ESP32-C3-WROOM-02')
    symbol_defs['RF_Module:ESP32-C3-WROOM-02'] = re.sub(r'\(symbol \"ESP32-C3-WROOM-02\"', '(symbol "RF_Module:ESP32-C3-WROOM-02"', raw_esp, count=1)

    raw_h = get_official_sym('Mechanical', 'MountingHole_Pad')
    symbol_defs['Mechanical:MountingHole_Pad'] = re.sub(r'\(symbol \"MountingHole_Pad\"', '(symbol "Mechanical:MountingHole_Pad"', raw_h, count=1)

    raw_pwrflg = get_official_sym('power', 'PWR_FLAG')
    symbol_defs['power:PWR_FLAG'] = re.sub(r'\(symbol \"PWR_FLAG\"', '(symbol "power:PWR_FLAG"', raw_pwrflg, count=1)

    # Standalone LED (Pad 1=Anode, Pad 2=Cathode matching PCB D3, D4)
    symbol_defs['Device:LED'] = '''\t\t(symbol "Device:LED"
\t\t\t(pin_numbers
\t\t\t\t(hide yes)
\t\t\t)
\t\t\t(pin_names
\t\t\t\t(offset 1.016)
\t\t\t\t(hide yes)
\t\t\t)
\t\t\t(exclude_from_sim no) (in_bom yes) (on_board yes)
\t\t\t(property "Reference" "D" (at 0 2.54 0) (effects (font (size 1.27 1.27))))
\t\t\t(property "Value" "LED" (at 0 -2.54 0) (effects (font (size 1.27 1.27))))
\t\t\t(property "Footprint" "" (at 0 0 0) (hide yes) (effects (font (size 1.27 1.27))))
\t\t\t(symbol "LED_0_1"
\t\t\t\t(polyline (pts (xy -1.27 -1.27) (xy -1.27 1.27) (xy 1.27 0) (xy -1.27 -1.27)) (stroke (width 0.254) (type default)) (fill (type none)))
\t\t\t\t(polyline (pts (xy 1.27 -1.27) (xy 1.27 1.27)) (stroke (width 0.254) (type default)) (fill (type none)))
\t\t\t)
\t\t\t(symbol "LED_1_1"
\t\t\t\t(pin passive line (at -3.81 0 0) (length 2.54) (name "A" (effects (font (size 1.27 1.27)))) (number "1" (effects (font (size 1.27 1.27)))))
\t\t\t\t(pin passive line (at 3.81 0 180) (length 2.54) (name "K" (effects (font (size 1.27 1.27)))) (number "2" (effects (font (size 1.27 1.27)))))
\t\t\t)
\t\t)'''

    # Standalone AMS1117-3.3 (Pin 1=GND, Pin 2=VO 3.3V, Pin 3=VI 5V)
    symbol_defs['Regulator_Linear:AMS1117-3.3'] = '''\t\t(symbol "Regulator_Linear:AMS1117-3.3"
\t\t\t(pin_names (offset 1.016))
\t\t\t(exclude_from_sim no) (in_bom yes) (on_board yes)
\t\t\t(property "Reference" "U" (at 0 5.08 0) (effects (font (size 1.27 1.27))))
\t\t\t(property "Value" "AMS1117-3.3" (at 0 -5.08 0) (effects (font (size 1.27 1.27))))
\t\t\t(property "Footprint" "Package_TO_SOT_SMD:SOT-223-3_TabPin2" (at 0 0 0) (hide yes) (effects (font (size 1.27 1.27))))
\t\t\t(symbol "AMS1117-3.3_0_1"
\t\t\t\t(rectangle (start -5.08 -5.08) (end 5.08 1.905) (stroke (width 0.254) (type default)) (fill (type background)))
\t\t\t)
\t\t\t(symbol "AMS1117-3.3_1_1"
\t\t\t\t(pin power_in line (at 0 -7.62 90) (length 2.54) (name "GND" (effects (font (size 1.27 1.27)))) (number "1" (effects (font (size 1.27 1.27)))))
\t\t\t\t(pin power_out line (at 7.62 0 180) (length 2.54) (name "VO" (effects (font (size 1.27 1.27)))) (number "2" (effects (font (size 1.27 1.27)))))
\t\t\t\t(pin power_in line (at -7.62 0 0) (length 2.54) (name "VI" (effects (font (size 1.27 1.27)))) (number "3" (effects (font (size 1.27 1.27)))))
\t\t\t)
\t\t)'''

    # Standalone Terminal Blocks (KF301 2P, 3P, 4P)
    for pcount, pnum_list in [(2, ["1", "2"]), (3, ["1", "2", "3"]), (4, ["1", "2", "3", "4"])]:
        lines_tb = []
        lines_tb.append(f'\t\t(symbol "TerminalBlock:KF301-{pcount}P"')
        lines_tb.append('\t\t\t(pin_names (offset 1.016))')
        lines_tb.append('\t\t\t(exclude_from_sim no) (in_bom yes) (on_board yes)')
        lines_tb.append(f'\t\t\t(property "Reference" "TB" (at 0 {pcount*1.27+1.27:.2f} 0) (effects (font (size 1.27 1.27))))')
        lines_tb.append(f'\t\t\t(property "Value" "KF301-{pcount}P" (at 0 {-pcount*1.27-1.27:.2f} 0) (effects (font (size 1.27 1.27))))')
        lines_tb.append('\t\t\t(property "Footprint" "" (at 0 0 0) (hide yes) (effects (font (size 1.27 1.27))))')
        lines_tb.append(f'\t\t\t(symbol "KF301-{pcount}P_0_1"')
        lines_tb.append(f'\t\t\t\t(rectangle (start -1.27 {pcount*1.27:.2f}) (end 1.27 {-pcount*1.27:.2f}) (stroke (width 0.254) (type default)) (fill (type background)))')
        lines_tb.append('\t\t\t)')
        lines_tb.append(f'\t\t\t(symbol "KF301-{pcount}P_1_1"')
        for idx, pn in enumerate(pnum_list):
            py = (pcount - 1) * 1.27 - idx * 2.54
            lines_tb.append(f'\t\t\t\t(pin passive line (at -5.08 {py:.2f} 0) (length 3.81) (name "{pn}" (effects (font (size 1.27 1.27)))) (number "{pn}" (effects (font (size 1.27 1.27)))))')
        lines_tb.append('\t\t\t)')
        lines_tb.append('\t\t)')
        symbol_defs[f'TerminalBlock:KF301-{pcount}P'] = '\n'.join(lines_tb)

    # Standalone Sockets MOD1 (4P) & MOD2 (5P)
    for pcount in [4, 5]:
        lines_sock = []
        lines_sock.append(f'\t\t(symbol "Connector_Generic:Conn_01x0{pcount}_Socket"')
        lines_sock.append('\t\t\t(pin_names (offset 1.016))')
        lines_sock.append('\t\t\t(exclude_from_sim no) (in_bom yes) (on_board yes)')
        lines_sock.append(f'\t\t\t(property "Reference" "J" (at 0 {pcount*1.27+1.27:.2f} 0) (effects (font (size 1.27 1.27))))')
        lines_sock.append(f'\t\t\t(property "Value" "Conn_01x0{pcount}_Socket" (at 0 {-pcount*1.27-1.27:.2f} 0) (effects (font (size 1.27 1.27))))')
        lines_sock.append('\t\t\t(property "Footprint" "" (at 0 0 0) (hide yes) (effects (font (size 1.27 1.27))))')
        lines_sock.append(f'\t\t\t(symbol "Conn_01x0{pcount}_Socket_0_1"')
        lines_sock.append(f'\t\t\t\t(rectangle (start -1.27 {pcount*1.27:.2f}) (end 1.27 {-pcount*1.27:.2f}) (stroke (width 0.254) (type default)) (fill (type background)))')
        lines_sock.append('\t\t\t)')
        lines_sock.append(f'\t\t\t(symbol "Conn_01x0{pcount}_Socket_1_1"')
        for p in range(1, pcount + 1):
            py = (pcount + 1) * 1.27 - p * 2.54
            lines_sock.append(f'\t\t\t\t(pin passive line (at -5.08 {py:.2f} 0) (length 3.81) (name "Pin_{p}" (effects (font (size 1.27 1.27)))) (number "{p}" (effects (font (size 1.27 1.27)))))')
        lines_sock.append('\t\t\t)')
        lines_sock.append('\t\t)')
        symbol_defs[f'Connector_Generic:Conn_01x0{pcount}_Socket'] = '\n'.join(lines_sock)

    # Append all lib symbols
    symbol_pins = {}
    for lib_id, code in symbol_defs.items():
        lines.append(code)
        symbol_pins[lib_id] = extract_pins(code)

    lines.append('\t)')

    pin_locations = {}

    def place_symbol(ref, val, footprint, lcsc, lib_id, gx, gy, rot=0, dnp=False):
        sx = G(gx)
        sy = G(gy)
        dnp_str = " (dnp yes)" if dnp else ""
        sym_uuid = u()
        lines.append(f'\t(symbol (lib_id "{lib_id}") (at {sx} {sy} {rot}) (unit 1)')
        lines.append(f'\t\t(in_bom yes) (on_board yes){dnp_str}')
        lines.append(f'\t\t(uuid "{sym_uuid}")')
        lines.append(f'\t\t(property "Reference" "{ref}" (at {round(sx+2.54, 4)} {round(sy-2.54, 4)} 0) (effects (font (size 1.27 1.27)) (justify left)))')
        lines.append(f'\t\t(property "Value" "{val}" (at {round(sx+2.54, 4)} {sy} 0) (effects (font (size 1.27 1.27)) (justify left)))')
        lines.append(f'\t\t(property "Footprint" "{footprint}" (at {sx} {sy} 0) (hide yes) (effects (font (size 1.27 1.27))))')
        if lcsc:
            lines.append(f'\t\t(property "LCSC" "{lcsc}" (at {sx} {sy} 0) (hide yes) (effects (font (size 1.27 1.27))))')
        
        rad = math.radians(rot)
        for pnum, (px, py) in symbol_pins[lib_id].items():
            lines.append(f'\t\t(pin "{pnum}" (uuid "{u()}"))')
            x_rot = px * math.cos(rad) - py * math.sin(rad)
            y_rot = px * math.sin(rad) + py * math.cos(rad)
            cx = round(sx + x_rot, 4)
            cy = round(sy - y_rot, 4)
            pin_locations[(ref, pnum)] = (cx, cy)
        
        lines.append('\t\t(instances')
        lines.append('\t\t\t(project "plant-esp32-onboard"')
        lines.append(f'\t\t\t\t(path "/08d48698-8ae9-4579-b376-0c39bd9de789/{sym_uuid}"')
        lines.append(f'\t\t\t\t\t(reference "{ref}") (unit 1)')
        lines.append('\t\t\t\t)')
        lines.append('\t\t\t)')
        lines.append('\t\t)')
        lines.append('\t)')

    def place_pwr_flag(net, gx, gy):
        sx = G(gx)
        sy = G(gy)
        sym_uuid = u()
        ref = f"#FLG{gx}_{gy}"
        lines.append(f'\t(symbol (lib_id "power:PWR_FLAG") (at {sx} {sy} 0) (unit 1)')
        lines.append('\t\t(in_bom no) (on_board no)')
        lines.append(f'\t\t(uuid "{sym_uuid}")')
        lines.append(f'\t\t(property "Reference" "{ref}" (at {round(sx+2.54, 4)} {round(sy-2.54, 4)} 0) (hide yes))')
        lines.append(f'\t\t(property "Value" "PWR_FLAG" (at {round(sx+2.54, 4)} {sy} 0) (hide yes))')
        lines.append(f'\t\t(property "Footprint" "" (at {sx} {sy} 0) (hide yes))')
        lines.append('\t\t(pin "1" (uuid "' + u() + '"))')
        lines.append('\t\t(instances')
        lines.append('\t\t\t(project "plant-esp32-onboard"')
        lines.append(f'\t\t\t\t(path "/08d48698-8ae9-4579-b376-0c39bd9de789/{sym_uuid}"')
        lines.append(f'\t\t\t\t\t(reference "{ref}") (unit 1)')
        lines.append('\t\t\t\t)')
        lines.append('\t\t\t)')
        lines.append('\t\t)')
        lines.append('\t)')
        add_wire(sx, sy, sx, round(sy - G(2), 4))
        add_label(net, sx, round(sy - G(2), 4), 90)

    def add_wire(x1, y1, x2, y2):
        lines.append(f'\t(wire (pts (xy {x1} {y1}) (xy {x2} {y2})) (stroke (width 0) (type default)) (uuid "{u()}"))')

    def add_label(net, x, y, rot=0):
        lines.append(f'\t(label "{net}" (at {x} {y} {rot}) (fields_autoplaced yes) (effects (font (size 1.27 1.27))) (uuid "{u()}"))')

    def add_junction(x, y):
        lines.append(f'\t(junction (at {x} {y}) (diameter 1.0) (color 0 0 0 0) (uuid "{u()}"))')

    def add_no_connect(x, y):
        lines.append(f'\t(no_connect (at {x} {y}) (uuid "{u()}"))')

    def wire_out_label(ref, pnum, net, dx_grid, dy_grid, label_rot):
        x, y = pin_locations[(ref, pnum)]
        tx = round(x + G(dx_grid), 4)
        ty = round(y + G(dy_grid), 4)
        add_wire(x, y, tx, ty)
        add_label(net, tx, ty, label_rot)

    # =========================================================================
    # PLACEMENT (ALL ON STRICT 50-MIL GRID)
    # =========================================================================

    # 1. ESP32-C3-WROOM-02 (U1) placed at (140, 80)
    place_symbol("U1", "ESP32-C3-WROOM-02", "RF_Module:ESP32-C3-WROOM-02", "C2934560", "RF_Module:ESP32-C3-WROOM-02", 140, 80, rot=0)

    # 2. Power Regulation: U2 AMS1117-3.3, C10 (10uF), C7 (100nF), C11 (10uF), C8 (100nF), C12 (22uF bulk)
    place_symbol("U2", "AMS1117-3.3", "Package_TO_SOT_SMD:SOT-223-3_TabPin2", "C6186", "Regulator_Linear:AMS1117-3.3", 60, 40, rot=0)
    place_symbol("C10", "10uF", "Capacitor_SMD:C_0805_2012Metric", "C15850", "Device:C", 40, 40, rot=0)
    place_symbol("C7", "100nF", "Capacitor_SMD:C_0805_2012Metric", "C28233", "Device:C", 48, 40, rot=0)
    place_symbol("C11", "10uF", "Capacitor_SMD:C_0805_2012Metric", "C15850", "Device:C", 76, 40, rot=0)
    place_symbol("C8", "100nF", "Capacitor_SMD:C_0805_2012Metric", "C28233", "Device:C", 84, 40, rot=0)
    place_symbol("C12", "22uF", "Capacitor_SMD:C_0805_2012Metric", "C45783", "Device:C", 92, 40, rot=0)

    # 3. USB-C Receptacle (J1) & CC Resistors (R12, R13)
    place_symbol("J1", "TYPE-C-16P", "Connector_USB:USB_C_Receptacle_HRO_TYPE-C-31-M-12", "C165948", "Connector:USB_C_Receptacle_USB2.0_16P", 50, 85, rot=0)
    place_symbol("R12", "5.1k", "Resistor_SMD:R_0805_2012Metric", "C27834", "Device:R", 24, 80, rot=0)
    place_symbol("R13", "5.1k", "Resistor_SMD:R_0805_2012Metric", "C27834", "Device:R", 34, 80, rot=0)

    # 4. Reset & Boot Circuitry (SW1, SW2, R10, R11, C9)
    place_symbol("R10", "10k", "Resistor_SMD:R_0805_2012Metric", "C17414", "Device:R", 80, 72, rot=0)
    place_symbol("C9", "1uF", "Capacitor_SMD:C_0805_2012Metric", "C28323", "Device:C", 90, 72, rot=0)
    place_symbol("SW1", "RST", "Button_Switch_SMD:SW_Push_1P1T_XKB_TS-1187A", "C318884", "Switch:SW_Push", 104, 72, rot=0)

    place_symbol("R11", "10k", "Resistor_SMD:R_0805_2012Metric", "C17414", "Device:R", 80, 105, rot=0)
    place_symbol("SW2", "BOOT", "Button_Switch_SMD:SW_Push_1P1T_XKB_TS-1187A", "C318884", "Switch:SW_Push", 96, 105, rot=0)

    # 5. LEDs (D3 PWR_GREEN, D4 STAT_BLUE, R14 1k, R15 1k)
    place_symbol("D3", "PWR_GREEN", "LED_SMD:LED_0805_2012Metric", "C2297", "Device:LED", 40, 130, rot=0)
    place_symbol("R14", "1k", "Resistor_SMD:R_0805_2012Metric", "C17513", "Device:R", 52, 130, rot=90)
    place_symbol("D4", "STAT_BLUE", "LED_SMD:LED_0805_2012Metric", "C2293", "Device:LED", 40, 145, rot=0)
    place_symbol("R15", "1k", "Resistor_SMD:R_0805_2012Metric", "C17513", "Device:R", 52, 145, rot=90)

    # 6. ADC Dividers: 5V Rail (R1, R2, C1) & Battery (R8, R9, C6)
    place_symbol("R1", "100k", "Resistor_SMD:R_0805_2012Metric", "C149504", "Device:R", 195, 36, rot=0)
    place_symbol("R2", "100k", "Resistor_SMD:R_0805_2012Metric", "C149504", "Device:R", 195, 48, rot=180)
    place_symbol("C1", "100nF", "Capacitor_SMD:C_0805_2012Metric", "C28233", "Device:C", 207, 48, rot=180)

    place_symbol("R8", "100k", "Resistor_SMD:R_0805_2012Metric", "C149504", "Device:R", 225, 36, rot=180)
    place_symbol("R9", "100k", "Resistor_SMD:R_0805_2012Metric", "C149504", "Device:R", 225, 48, rot=0)
    place_symbol("C6", "100nF", "Capacitor_SMD:C_0805_2012Metric", "C28233", "Device:C", 237, 48, rot=0)

    # 7. Level Shifters & Sensor Filters (R3, R4, C2, R7, R_LDR1, C4)
    place_symbol("R3", "1k", "Resistor_SMD:R_0805_2012Metric", "C17513", "Device:R", 195, 78, rot=0)
    place_symbol("R4", "2k", "Resistor_SMD:R_0805_2012Metric", "C17604", "Device:R", 195, 90, rot=0)

    place_symbol("C2", "100nF", "Capacitor_SMD:C_0805_2012Metric", "C28233", "Device:C", 195, 114, rot=0)
    place_symbol("R_LDR1", "LDR_5528", "OptoDevice:R_LDR_5.1x4.3mm_P3.4mm_Vertical", "", "Device:R_Photo", 215, 108, rot=0, dnp=True)
    place_symbol("R7", "10k", "Resistor_SMD:R_0805_2012Metric", "C17414", "Device:R", 215, 120, rot=180)
    place_symbol("C4", "100nF", "Capacitor_SMD:C_0805_2012Metric", "C28233", "Device:C", 227, 120, rot=180)

    # 8. MOSFET Pump Driver (R5, R6, Q1, D1)
    place_symbol("R5", "1k", "Resistor_SMD:R_0805_2012Metric", "C17513", "Device:R", 195, 144, rot=90)
    place_symbol("R6", "100k", "Resistor_SMD:R_0805_2012Metric", "C149504", "Device:R", 203, 156, rot=0)
    place_symbol("Q1", "AO3400A", "Package_TO_SOT_SMD:SOT-23", "C20917", "Transistor_FET:AO3400A", 215, 144, rot=0)
    place_symbol("D1", "SS34", "Diode_SMD:D_SMA", "C8678", "Device:D_Schottky", 229, 140, rot=90)

    # 9. Anti-backfeed D2 (SS34)
    place_symbol("D2", "SS34", "Diode_SMD:D_SMA", "C8678", "Device:D_Schottky", 229, 80, rot=0)

    # 10. Terminal Blocks (TB1, TB2, TB3, TB4) at x=265
    place_symbol("TB1", "ULTRASONIC", "TerminalBlock:TerminalBlock_KF301-4P_P5.00mm", "C8354", "TerminalBlock:KF301-4P", 265, 36, rot=0)
    place_symbol("TB2", "SOIL_SENSOR", "TerminalBlock:TerminalBlock_KF301-3P_P5.00mm", "C8353", "TerminalBlock:KF301-3P", 265, 72, rot=0)
    place_symbol("TB3", "PUMP_MOTOR", "TerminalBlock:TerminalBlock_KF301-2P_P5.00mm", "C8352", "TerminalBlock:KF301-2P", 265, 102, rot=0)
    place_symbol("TB4", "EXT_POWER_BAT", "TerminalBlock:TerminalBlock_KF301-3P_P5.00mm_Vertical", "C8353", "TerminalBlock:KF301-3P", 265, 132, rot=0)

    # 11. Sensor Sockets MOD1 (SHT30) & MOD2 (BH1750)
    place_symbol("MOD1", "SHT30_I2C", "Connector_PinSocket_2.54mm:PinSocket_1x04_P2.54mm_Vertical", "", "Connector_Generic:Conn_01x04_Socket", 120, 145, rot=0, dnp=True)
    place_symbol("MOD2", "BH1750_I2C", "Connector_PinSocket_2.54mm:PinSocket_1x05_P2.54mm_Vertical", "", "Connector_Generic:Conn_01x05_Socket", 155, 145, rot=0, dnp=True)

    # 12. Mounting Holes H1-H4
    place_symbol("H1", "MountingHole_Pad", "MountingHole:MountingHole_3.2mm_M3_Pad", "", "Mechanical:MountingHole_Pad", 250, 156, rot=0)
    place_symbol("H2", "MountingHole_Pad", "MountingHole:MountingHole_3.2mm_M3_Pad", "", "Mechanical:MountingHole_Pad", 258, 156, rot=0)
    place_symbol("H3", "MountingHole_Pad", "MountingHole:MountingHole_3.2mm_M3_Pad", "", "Mechanical:MountingHole_Pad", 266, 156, rot=0)
    place_symbol("H4", "MountingHole_Pad", "MountingHole:MountingHole_3.2mm_M3_Pad", "", "Mechanical:MountingHole_Pad", 274, 156, rot=0)

    # =========================================================================
    # WIRING (ALL ALIGNED TO 50-MIL GRID)
    # =========================================================================

    # --- U1 (ESP32-C3) Connections ---
    wire_out_label("U1", "1", "+3V3", 0, -4, 90)
    wire_out_label("U1", "2", "ESP_EN", -4, 0, 180)
    wire_out_label("U1", "3", "GPIO4_VBAT_ADC", -4, 0, 180)
    wire_out_label("U1", "4", "GPIO5_SOIL_VCC", -4, 0, 180)
    wire_out_label("U1", "5", "GPIO6_ECHO", -4, 0, 180)
    wire_out_label("U1", "6", "GPIO7_GATE", -4, 0, 180)
    wire_out_label("U1", "7", "GPIO8_LED", -4, 0, 180)
    wire_out_label("U1", "8", "GPIO9_BOOT", -4, 0, 180)
    wire_out_label("U1", "9", "GND", 0, 4, 270)

    wire_out_label("U1", "18", "GPIO0_5V_ADC", -4, 0, 180)
    wire_out_label("U1", "17", "GPIO1_SOIL", -4, 0, 180)
    add_no_connect(*pin_locations[("U1", "16")])
    wire_out_label("U1", "15", "GPIO3_LDR", -4, 0, 180)
    wire_out_label("U1", "14", "USB_DP", -4, 0, 180)
    wire_out_label("U1", "13", "USB_DN", -4, 0, 180)
    wire_out_label("U1", "12", "GPIO21_SCL", 4, 0, 0)
    wire_out_label("U1", "11", "GPIO20_SDA", 4, 0, 0)
    wire_out_label("U1", "10", "GPIO10_TRIG", -4, 0, 180)
    wire_out_label("U1", "19", "GND", 0, 6, 270)

    # --- Power Regulation U2 & Caps ---
    wire_out_label("U2", "3", "+5V", -4, 0, 180)
    wire_out_label("U2", "2", "+3V3", 4, 0, 0)
    wire_out_label("U2", "1", "GND", 0, 4, 270)
    place_pwr_flag("+5V", 46, 36)
    place_pwr_flag("GND", 46, 44)

    for cap in ["C10", "C7"]:
        wire_out_label(cap, "1", "+5V", 0, -4, 90)
        wire_out_label(cap, "2", "GND", 0, 4, 270)

    for cap in ["C11", "C8", "C12"]:
        wire_out_label(cap, "1", "+3V3", 0, -4, 90)
        wire_out_label(cap, "2", "GND", 0, 4, 270)

    # --- USB-C J1 ---
    # Tie all VBUS pins together to +5V
    wire_out_label("J1", "A4", "+5V", 4, 0, 0)
    wire_out_label("J1", "B9", "+5V", 4, 0, 0)
    wire_out_label("J1", "B4", "+5V", 4, 0, 0)
    wire_out_label("J1", "A9", "+5V", 4, 0, 0)

    wire_out_label("J1", "A6", "USB_DP", 4, 0, 0)
    wire_out_label("J1", "B6", "USB_DP", 4, 0, 0)
    wire_out_label("J1", "A7", "USB_DN", 4, 0, 0)
    wire_out_label("J1", "B7", "USB_DN", 4, 0, 0)

    wire_out_label("J1", "A5", "USB_CC1", 4, 0, 0)
    wire_out_label("J1", "B5", "USB_CC2", 4, 0, 0)
    wire_out_label("R12", "1", "USB_CC1", 0, -4, 90)
    wire_out_label("R12", "2", "GND", 0, 4, 270)
    wire_out_label("R13", "1", "USB_CC2", 0, -4, 90)
    wire_out_label("R13", "2", "GND", 0, 4, 270)

    # GND pins
    for gp in ["A1", "B12", "B1", "A12", "SH"]:
        wire_out_label("J1", gp, "GND", 0, 4, 270)

    # Unconnected SBU pins
    add_no_connect(*pin_locations[("J1", "A8")])
    add_no_connect(*pin_locations[("J1", "B8")])

    # --- Reset & Boot ---
    wire_out_label("SW1", "1", "ESP_EN", -4, 0, 180)
    wire_out_label("SW1", "2", "GND", 4, 0, 0)
    wire_out_label("R10", "1", "+3V3", 0, -4, 90)
    wire_out_label("R10", "2", "ESP_EN", 0, 4, 270)
    wire_out_label("C9", "1", "GND", 0, -4, 90)
    wire_out_label("C9", "2", "ESP_EN", 0, 4, 270)

    wire_out_label("SW2", "1", "GND", -4, 0, 180)
    wire_out_label("SW2", "2", "GPIO9_BOOT", 4, 0, 0)
    wire_out_label("R11", "1", "+3V3", 0, -4, 90)
    wire_out_label("R11", "2", "GPIO9_BOOT", 0, 4, 270)

    # --- LEDs ---
    wire_out_label("D3", "1", "+3V3", -4, 0, 180)
    d3_p2 = pin_locations[("D3", "2")]
    r14_p1 = pin_locations[("R14", "1")]
    add_wire(d3_p2[0], d3_p2[1], r14_p1[0], r14_p1[1])
    add_label("PWR_LED_K", d3_p2[0], round(d3_p2[1]-G(2), 4), 90)
    add_wire(d3_p2[0], d3_p2[1], d3_p2[0], round(d3_p2[1]-G(2), 4))
    wire_out_label("R14", "2", "GND", 4, 0, 0)

    wire_out_label("D4", "1", "+3V3", -4, 0, 180)
    d4_p2 = pin_locations[("D4", "2")]
    r15_p1 = pin_locations[("R15", "1")]
    add_wire(d4_p2[0], d4_p2[1], r15_p1[0], r15_p1[1])
    add_label("STAT_LED_K", d4_p2[0], round(d4_p2[1]-G(2), 4), 90)
    add_wire(d4_p2[0], d4_p2[1], d4_p2[0], round(d4_p2[1]-G(2), 4))
    wire_out_label("R15", "2", "GPIO8_LED", 4, 0, 0)

    # --- 5V ADC Divider (R1, R2, C1) ---
    wire_out_label("R1", "1", "+5V", 0, -4, 90)
    mid_5v = G(42)
    r1_p2 = pin_locations[("R1", "2")]
    r2_p2 = pin_locations[("R2", "2")]
    c1_p2 = pin_locations[("C1", "2")]
    add_wire(r1_p2[0], r1_p2[1], r1_p2[0], mid_5v)
    add_wire(r2_p2[0], r2_p2[1], r2_p2[0], mid_5v)
    add_junction(r1_p2[0], mid_5v)
    add_wire(r1_p2[0], mid_5v, c1_p2[0], mid_5v)
    add_wire(c1_p2[0], c1_p2[1], c1_p2[0], mid_5v)
    add_junction(c1_p2[0], mid_5v)
    add_wire(c1_p2[0], mid_5v, round(c1_p2[0]+G(4), 4), mid_5v)
    add_label("GPIO0_5V_ADC", round(c1_p2[0]+G(4), 4), mid_5v, 0)
    wire_out_label("R2", "1", "GND", 0, 4, 270)
    wire_out_label("C1", "1", "GND", 0, 4, 270)

    # --- Battery ADC Divider (R8, R9, C6) ---
    wire_out_label("R8", "2", "VBAT_SENSE", 0, -4, 90)
    mid_bat = G(42)
    r8_p1 = pin_locations[("R8", "1")]
    r9_p1 = pin_locations[("R9", "1")]
    c6_p1 = pin_locations[("C6", "1")]
    add_wire(r8_p1[0], r8_p1[1], r8_p1[0], mid_bat)
    add_wire(r9_p1[0], r9_p1[1], r9_p1[0], mid_bat)
    add_junction(r8_p1[0], mid_bat)
    add_wire(r8_p1[0], mid_bat, c6_p1[0], mid_bat)
    add_wire(c6_p1[0], c6_p1[1], c6_p1[0], mid_bat)
    add_junction(c6_p1[0], mid_bat)
    add_wire(c6_p1[0], mid_bat, round(c6_p1[0]+G(4), 4), mid_bat)
    add_label("GPIO4_VBAT_ADC", round(c6_p1[0]+G(4), 4), mid_bat, 0)
    wire_out_label("R9", "2", "GND", 0, 4, 270)
    wire_out_label("C6", "2", "GND", 0, 4, 270)

    # --- Ultrasonic Level Divider (R3, R4) ---
    wire_out_label("R3", "1", "ECHO_5V", 0, -4, 90)
    mid_echo = G(84)
    r3_p2 = pin_locations[("R3", "2")]
    r4_p1 = pin_locations[("R4", "1")]
    add_wire(r3_p2[0], r3_p2[1], r3_p2[0], mid_echo)
    add_wire(r4_p1[0], r4_p1[1], r4_p1[0], mid_echo)
    add_junction(r3_p2[0], mid_echo)
    add_wire(r3_p2[0], mid_echo, round(r3_p2[0]+G(4), 4), mid_echo)
    add_label("GPIO6_ECHO", round(r3_p2[0]+G(4), 4), mid_echo, 0)
    wire_out_label("R4", "2", "GND", 0, 4, 270)

    # --- Soil Sensor Filter (C2) ---
    wire_out_label("C2", "1", "GPIO1_SOIL", 0, -4, 90)
    wire_out_label("C2", "2", "GND", 0, 4, 270)

    # --- LDR Sensor (R_LDR1, R7, C4) ---
    wire_out_label("R_LDR1", "1", "+3V3", 0, -4, 90)
    mid_ldr = G(114)
    ldr_p2 = pin_locations[("R_LDR1", "2")]
    r7_p2 = pin_locations[("R7", "2")]
    c4_p2 = pin_locations[("C4", "2")]
    add_wire(ldr_p2[0], ldr_p2[1], ldr_p2[0], mid_ldr)
    add_wire(r7_p2[0], r7_p2[1], r7_p2[0], mid_ldr)
    add_junction(ldr_p2[0], mid_ldr)
    add_wire(ldr_p2[0], mid_ldr, c4_p2[0], mid_ldr)
    add_wire(c4_p2[0], c4_p2[1], c4_p2[0], mid_ldr)
    add_junction(c4_p2[0], mid_ldr)
    add_wire(c4_p2[0], mid_ldr, round(c4_p2[0]+G(4), 4), mid_ldr)
    add_label("GPIO3_LDR", round(c4_p2[0]+G(4), 4), mid_ldr, 0)
    wire_out_label("R7", "1", "GND", 0, 4, 270)
    wire_out_label("C4", "1", "GND", 0, 4, 270)

    # --- Pump MOSFET Driver (R5, R6, Q1, D1) ---
    wire_out_label("R5", "1", "GPIO7_GATE", -4, 0, 180)
    r5_p2 = pin_locations[("R5", "2")]
    q1_p1 = pin_locations[("Q1", "1")]
    r6_p1 = pin_locations[("R6", "1")]
    add_wire(r5_p2[0], r5_p2[1], q1_p1[0], q1_p1[1])
    add_wire(r6_p1[0], r6_p1[1], r6_p1[0], r5_p2[1])
    add_junction(r6_p1[0], r5_p2[1])
    add_wire(r6_p1[0], r5_p2[1], round(r6_p1[0], 4), round(r5_p2[1]-G(3), 4))
    add_label("GATE_DRIVE", r6_p1[0], round(r5_p2[1]-G(3), 4), 90)
    wire_out_label("R6", "2", "GND", 0, 4, 270)

    wire_out_label("Q1", "2", "GND", 0, 4, 270)
    wire_out_label("Q1", "3", "PUMP_DRAIN", 4, 0, 0)

    wire_out_label("D1", "1", "+5V", 0, 4, 270)
    wire_out_label("D1", "2", "PUMP_DRAIN", 0, -4, 90)

    # --- Anti-backfeed Diode D2 ---
    wire_out_label("D2", "1", "+5V", -4, 0, 180)
    wire_out_label("D2", "2", "EXT_5V", 4, 0, 0)

    # --- Terminal Blocks ---
    wire_out_label("TB1", "1", "+5V", -4, 0, 180)
    wire_out_label("TB1", "2", "GPIO10_TRIG", -4, 0, 180)
    wire_out_label("TB1", "3", "ECHO_5V", -4, 0, 180)
    wire_out_label("TB1", "4", "GND", -4, 0, 180)

    wire_out_label("TB2", "1", "GPIO1_SOIL", -4, 0, 180)
    wire_out_label("TB2", "2", "GPIO5_SOIL_VCC", -4, 0, 180)
    wire_out_label("TB2", "3", "GND", -4, 0, 180)

    wire_out_label("TB3", "1", "+5V", -4, 0, 180)
    wire_out_label("TB3", "2", "PUMP_DRAIN", -4, 0, 180)

    wire_out_label("TB4", "1", "EXT_5V", -4, 0, 180)
    wire_out_label("TB4", "2", "GND", -4, 0, 180)
    wire_out_label("TB4", "3", "VBAT_SENSE", -4, 0, 180)

    # --- MOD1 & MOD2 ---
    wire_out_label("MOD1", "1", "+3V3", -4, 0, 180)
    wire_out_label("MOD1", "2", "GND", -4, 0, 180)
    wire_out_label("MOD1", "3", "GPIO21_SCL", -4, 0, 180)
    wire_out_label("MOD1", "4", "GPIO20_SDA", -4, 0, 180)

    wire_out_label("MOD2", "1", "+3V3", -4, 0, 180)
    wire_out_label("MOD2", "2", "GND", -4, 0, 180)
    wire_out_label("MOD2", "3", "GPIO21_SCL", -4, 0, 180)
    wire_out_label("MOD2", "4", "GPIO20_SDA", -4, 0, 180)
    wire_out_label("MOD2", "5", "GND", -4, 0, 180)

    # --- Mounting Holes H1-H4 ---
    for h in ["H1", "H2", "H3", "H4"]:
        wire_out_label(h, "1", "GND", 0, 4, 270)

    lines.append(')')
    return '\n'.join(lines) + '\n'

def main():
    script_dir = os.path.dirname(os.path.abspath(__file__))
    sch_path = os.path.join(script_dir, "plant-esp32-onboard.kicad_sch")
    content = build_schematic()
    with open(sch_path, "w") as f:
        f.write(content)
    print(f"Successfully generated {sch_path} ({len(content)} bytes)")

if __name__ == "__main__":
    main()
