thomaslr/plant-esp32/(commit log)

2026-10-10 feat: add breadboard circuit guides and interactive HTML circuit diagrams
2026-10-11 feat: implement sensor management, safety checks, and web server for ESP32 plant monitor
2026-10-11 feat: make circuit diagram fluid for wide monitors with interactive zoom toolbar
2026-10-11 Add 18x24 perfboard circuit guide and interactive SVG diagram
2026-10-11 Invert perfboard rows to descending R-A and explicitly show physical wiring connections
2026-10-11 Explicitly render all physical perfboard wiring, bus conductors, solder bridges, and jumpers
2026-10-11 Fix R1/R2/C1 voltage divider layout and align TB2 pinout to eliminate crossovers
2026-10-11 Move ESP32-C3 down two rows to Row J and Row D, shifting supply divider to Row K
2026-10-11 Update C3 to 100uF across VCC-GND and separate flyback diode from motor terminal
2026-10-11 Move flyback diode up to Row E and C1 left leg to L4
2026-10-11 Trim Row A Power GND bus to A18-A20 and fix Q1 Source lead rendering
2026-10-11 Connect right leg of C1 to K6
2026-10-11 Move actuator block left: D1 right side at E15 (E13-E15), Q1 at C12-C14, TB3 at B13/B15
2026-10-11 Connect N15 to E15: straight vertical 5V feed down Column 15
2026-10-11 Connect P14 to D14 with 4-pad solder bridge down to A14
2026-10-11 Implement anti-short dual-layer wiring split and visualizer toggles
2026-10-11 Optimize dual-layer wiring: 9 top wires, 15 bottom connections with backups
2026-10-11 Mirror ghosted top components in bottom solder side view
2026-10-11 Update wire routing: M4->P4, P4->P11, and K7->O7 with J7-K7 bridge
2026-10-11 Move top jumper wires from J8-J10 to K8-K10 with solder bridges
2026-10-12 feat(pcb): add complete KiCad 8 project, Gerbers, and 3D renders for plant-esp32
    [plant-esp32-B_Courtyard.gbr, plant-esp32-B_Cu.gbl, plant-esp32-B_Fab.gbr, plant-esp32-B_Mask.gbs, plant-esp32-B_Paste.gbp, plant-esp32-B_Silkscreen.gbo, plant-esp32-Edge_Cuts.gm1, plant-esp32-F_Courtyard.gbr]
2026-10-12 feat(pcb): adapt layout for modular KF301 5.0mm terminal blocks with verified clearances
    [plant-esp32-B_Courtyard.gbr, plant-esp32-B_Cu.gbl, plant-esp32-B_Fab.gbr, plant-esp32-B_Mask.gbs, plant-esp32-B_Paste.gbp, plant-esp32-B_Silkscreen.gbo, plant-esp32-Edge_Cuts.gm1, plant-esp32-F_Courtyard.gbr]
2026-10-26 1st rust firmware commit
    [freecad_enclosure_assembly.FCStd, freecad_enclosure_assembly.step, freecad_enclosure_base.step, freecad_enclosure_base.stl, freecad_enclosure_lid.step, freecad_enclosure_lid.stl, pcb_bottle_mount.scad, pcb_bottle_mount.stl]
2026-11-01 feat: add OpenSCAD enclosure model and renders for Plant ESP32 SMD controller
    [plant_esp32_smd_case.scad, plant_esp32_smd_case_base.stl, plant_esp32_smd_case_lid.stl, plant_esp32_smd_open_base.scad, plant_esp32_smd_open_base.stl]
2026-11-01 remove FreeCAD enclosure models and CAD scripts
    [freecad_enclosure_assembly.FCStd, freecad_enclosure_assembly.step, freecad_enclosure_base.step, freecad_enclosure_base.stl, freecad_enclosure_lid.step, freecad_enclosure_lid.stl, pcb_bottle_mount.scad, pcb_bottle_mount.stl]
2026-11-05 feat(firmware-rust): add dedicated LED supervisor with round-robin multi-fault signaling
2026-11-05 feat(wifi): add captive portal softap provisioning, web reset, and led pulse
    [app.js, led.rs, main.rs, storage.rs, web.rs, wifi.rs]
2026-11-05 feat(enclosure): update case scad, stl models, and render previews
    [plant_esp32_smd_case.scad, plant_esp32_smd_case_base.stl, plant_esp32_smd_case_lid.stl]
2026-11-05 fix(firmware): increase main task stack to 16KB and heap-allocate NVS buffer to prevent stack canary fault
    [storage.rs]
2026-11-05 chore(build): auto-generate empty secrets.rs stub if missing for public clones
    [build.rs]
2026-11-05 feat(ota): add dual-partition OTA, GitHub Releases client, web upload, and GitHub Actions workflow
    [partitions.csv]
2026-11-05 feat(ui): redesign dashboard with circular dials, colored zones, and config page
    [app.js, config.rs, sensors.rs]
2026-11-05 fix(web): disable static caching and add version query to force fresh UI assets
    [web.rs]
2026-11-05 fix(ui): add inline SVG presentation attributes to ensure dials render without CSS race condition
    [app.js]
2026-11-05 fix(hw): map 5V rail monitor to GPIO 4 (physical pin adjacent to 3V3 on SuperMini)
    [pins.rs, sensors.rs]
2026-11-05 feat: add system hostname config, device reboot control, and favicon
    [plant_esp32_smd_open_base.scad, plant_esp32_smd_open_base.stl]
2026-11-05 feat: add OTA changelog confirmation modal, GitHub CI build cache, and HTTP polling stability
    [app.js]
2026-11-05 fix(ota,wifi): fix OTA worker stack overflow and add WPA3 Wi-Fi retry loop (v0.1.7)
    [main.rs, ota.rs, web.rs, wifi.rs]
2026-11-05 fix(ota,led): fix HTTP_CLIENT out-of-buffer on GitHub redirects and add flashing LED strobe (v0.1.9)
    [led.rs, ota.rs]
2026-11-05 chore: bump version to v0.2.0 to test OTA slot rollover (ota_1 -> ota_0)
2026-11-05 docs: rewrite PROJECT.md to reflect Rust architecture, dual-slot OTA, and CI/CD
2026-11-05 feat(web): move sensor log to dedicated tab with limit selector (v0.2.2)
2026-11-06 feat(firmware): release v0.2.7 with PWM pump speed, web access LED indicator, 5s watering default, and canonical ESP32-C3 SuperMini pinout
    [plant-esp32-smd-B_Cu.gbl, plant-esp32-smd-B_Mask.gbs, plant-esp32-smd-B_Paste.gbp, plant-esp32-smd-B_Silkscreen.gbo, plant-esp32-smd-Edge_Cuts.gm1, plant-esp32-smd-F_Cu.gtl, plant-esp32-smd-F_Mask.gts, plant-esp32-smd-F_Paste.gtp]
2026-11-06 fix(ota): configure dual-OTA partition table (1984KB) and wire espflash runner
    [partitions.csv]
2026-11-06 fix(wifi): disable modem sleep during association and increase Deco mesh retry window to 10 attempts at 15s
    [wifi.rs]
2026-11-06 feat(wifi): configure maximum RF transmit power (78 / ~19.5 dBm) for wall-powered stability
    [wifi.rs]
2026-11-07 chore: bump firmware to v0.2.11 with Wi-Fi mesh stability enhancements and heartbeat watchdog
    [main.rs, wifi.rs]
2026-11-07 feat: add dynamic Y-axis auto-scale toggle and multi-sensor range fitting for telemetry chart (v0.2.16)
2026-11-08 Release v0.2.23: Set default water duration to 30s and align button with input bottom
2026-11-08 feat: add SHT30, BH1750, and LDR sensors with config toggles, live dials, and chart series
2026-11-08 chore: bump firmware to v0.2.28 with environmental sensors
2026-11-08 fix: implement Default for SensorsView and remove unused i2c imports
    [api.rs, i2c_bus.rs, web.rs]
2026-11-08 fix(web): resolve javascript syntax error in chart renderer and bump cache to v15
    [app.js]
2026-11-08 refactor(web): move optional environmental sensors card into settings tab
2026-11-09 feat: add persistent flash logging (survives reboots) and dedicated environmental table columns v0.2.30
    [app.js, main.rs, reading.rs, ring_buffer.rs, storage.rs]
2026-11-09 feat: add real-time clock with drift tracking and hourly NTP resync v0.2.31
    [api.rs, app.js, main.rs, web.rs]
2026-11-09 feat: simplify live clock without drift display v0.2.32
    [app.js]
2026-11-09 fix: switch PWA service worker to network-first for immediate UI updates v0.2.34
    [app.js]
2026-11-10 fix: allow 1-mV calibration precision and auto-conform sample inputs
    [app.js]
2026-11-10 feat: bulletproof NVS flash persistence for calibration & settings
2026-11-10 feat: clean sample now button label and decouple live telemetry
2026-11-10 fix: canonical 150ms settling for soil probe and dynamic dial calibration
    [app.js, sensors.rs, web.rs]
2026-11-10 feat: 1.0s probe settling and 25ms sub-sample AC ripple rejection
