thomaslr/plant-esp32/(notices)

Notices in the files:
README.md:
License: GPL v3
License: CERN-OHL-S v2
